YuzukiHD/R128Module/docs/hardware/ref_hardware_design.md

# 硬件设计参考

## R128 DevKit 开发板

- 硬件工程开源地址：[https://oshwhub.com/gloomyghost/r128-module](https://oshwhub.com/gloomyghost/r128-module)
- 电路图：[SCH_R128-DevKit_2023-09-05.pdf](https://www.aw-ol.com/downloads?cat=22)
- PCB：[ProDocument_R128-DevKit_2023-09-05.epro](https://www.aw-ol.com/downloads?cat=22)
- GERBER：[Gerber_R128-DevKit_2023-09-05.zip](https://www.aw-ol.com/downloads?cat=22)
- STL：[DXF_R128-DevKit_2023-09-05.dxf](https://www.aw-ol.com/downloads?cat=22)
- 3D STEP：[3D_R128-DevKit_2023-09-05.step](https://www.aw-ol.com/downloads?cat=22)
- BOM：[BOM_R128-DevKit_R128-DevKit_2023-09-05.xlsx](https://www.aw-ol.com/downloads?cat=22)
- 点位图：[PickAndPlace_R128-DevKit_2023-09-05.xlsx](https://www.aw-ol.com/downloads?cat=22)

## R128 EVT 开发套件

- 硬件工程开源地址：[https://oshwhub.com/gloomyghost/r128-module](https://oshwhub.com/gloomyghost/r128-module)
- 电路图：[SCH_R128_EVT_2023-10-20.pdf](https://www.aw-ol.com/downloads?cat=22)
- PCB：[ProDocument_R128-EVT_2023-10-20.epro](https://www.aw-ol.com/downloads?cat=22)
- GERBER：[Gerber_R128_EVT_2023-10-20.zip](https://www.aw-ol.com/downloads?cat=22)
- STL：[DXF_R128_EVT_2023-10-20.dxf](https://www.aw-ol.com/downloads?cat=22)
- 3D STEP：[3D_R128_EVT_2023-10-20.zip](https://www.aw-ol.com/downloads?cat=22)
- BOM：[BOM_R128-EVT_R128_EVT_2023-10-20.xlsx](https://www.aw-ol.com/downloads?cat=22)
- 点位图：[PickAndPlace_R128_EVT_2023-10-20.xlsx](https://www.aw-ol.com/downloads?cat=22)

## R128 模块

- 硬件工程开源地址：https://oshwhub.com/gloomyghost/r128-module
- 电路原理图：[SCH_R128-S2_2023-10-08.pdf](https://www.aw-ol.com/downloads?cat=22)
- PCB图：[PCB_R128-S2_2023-10-08.pdf](https://www.aw-ol.com/downloads?cat=22)
- PCB：[ProDocument_R128-S2-N16R16_2023-10-08.epro](https://www.aw-ol.com/downloads?cat=22)
- GERBER：[SCH_R128-S2_2023-10-08.pdf](https://www.aw-ol.com/downloads?cat=22)
- ODB++：[odb++_pcb_2023-10-08.zip](https://www.aw-ol.com/downloads?cat=22)
- 3D STEP：[3D_R128-S2_2023-10-08.zip](https://www.aw-ol.com/downloads?cat=22)
- BOM：[BOM_R128-S2-N16R16_R128-S2_2023-10-08.xlsx](https://www.aw-ol.com/downloads?cat=22)
- 点位图：[PickAndPlace_R128-S2_2023-10-08.xlsx](https://www.aw-ol.com/downloads?cat=22)
- 引脚图：[R128-S2-N16R16_PINOUT.svg](https://www.aw-ol.com/downloads?cat=22)
