YuzukiHD/R128Module/docs/hardware/chip_support_list.md

# 芯片外设支持列表

## LCD 显示屏
| 厂商 | 分辨率 | 型号 | 接口 | FPS  |
| --- | --- | --- | ---- | ---- |
| 100ask | 480 x 320 | Dshan_Display Module | SPI  | 60 |

## 摄像头 Sensor

| 厂商 | 分辨率 | 型号 | Size  | 接口 | FPS  |
| --- | --- | --- | ----- | ---- | ---- |
| GalaxyCore | VGA, 640 x 480 | GC0308 | 1/6.5 | DVP  | 30 |
| GalaxyCore | UXGA, 1616 x 1232 | GC2145 | 1/5 | DVP  | 13 |
