YuzukiHD/R128Module/docs/demo/lvgl_spi.md

# LVGL 与 SPI TFT GUI

本次使用的是 Dshan_Display Module，如下图：



引脚配置如下：

| R128 Devkit | TFT 模块 |
| --- | --- |
| PA12 | CS |
| PA13 | SCK |
| PA18 | MOSI |
| PA9 | PWM |
| PA20 | RESET |
| PA19 | RS |
| 3V3 | 3.3V |
| GND | GND |



## 载入方案

我们使用的开发板是 R128-Devkit，需要开发 C906 核心的应用程序，所以载入方案选择 `r128s2_module_c906`

```bash
$ source envsetup.sh 
$ lunch_rtos 1
```



## 配置 SPI LCD 驱动

驱动配置请参照 《SPI 驱动 TFT LCD 屏》文章进行配置。

## 配置 LVGL 软件包

运行 `mrtos_menuconfig` 进入配置页面。在如下地址找到勾选相关软件包。

```
System components  --->
	thirdparty components  --->
		[*] Littlevgl-8  --->
			[*]   lvgl examples
			[*]   lvgl-8.1.0 use sunxifb double buffer
			[*]   lvgl-8.1.0 use sunxifb cache
```

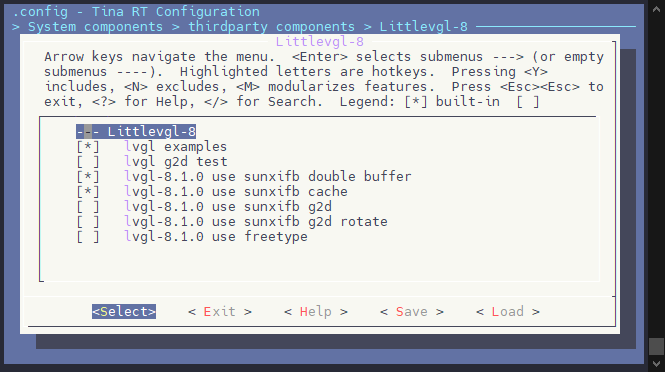
[picture p103: docs/demo/assets/post/lvgl_spi/image-20230825153504625.png]


注意，`lv_examples` 与 `lv_g2d_test` 不能同时勾选，否则会报错重复定义错误。

> 论坛提问：[想给R128移植上LVGL按照教程结果失败](https://bbs.aw-ol.com/topic/4421/share/1)



错误如下：

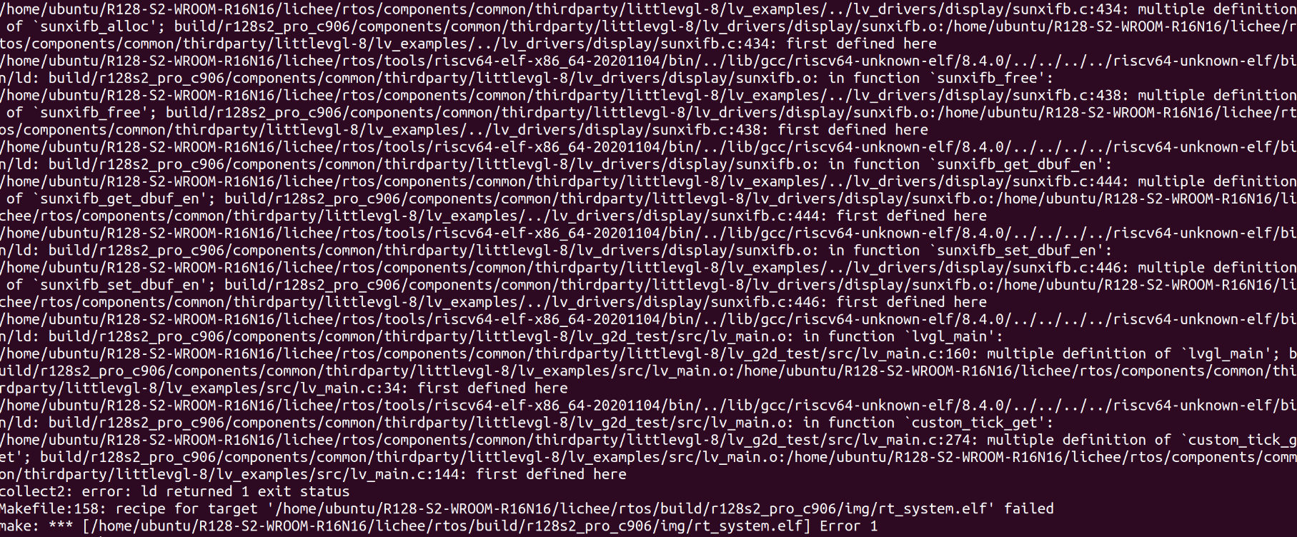
[picture p104: docs/demo/assets/post/lvgl_spi/image-20231016111544273.png]


如果出现 `update_mbr_failed`，请参照[常见问题](/others/faq)修改分区表增大分区容量

## 修改 LVGL 显示配置

### SPI 屏幕

进入 `lichee/rtos-components/thirdparty/littlevgl-8/lv_examples/src/lv_conf.h` 找到 `LV_COLOR_DEPTH` 并修改为 16 位，`LV_COLOR_16_SWAP` 置为 1 进行红蓝颜色交换。

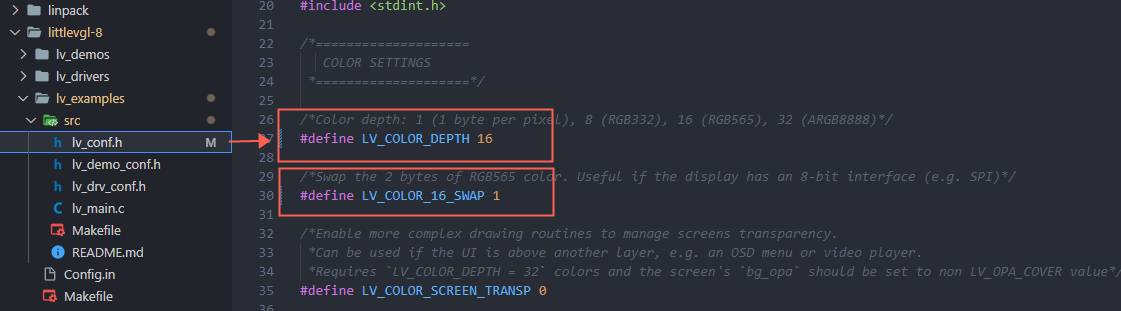
[picture p105: docs/demo/assets/post/lvgl_spi/image-20230825153629754.png]


### DBI 屏幕

进入 `lichee/rtos-components/thirdparty/littlevgl-8/lv_examples/src/lv_conf.h` 找到 `LV_COLOR_DEPTH` 并修改为 16 位，DBI 不需要配置`LV_COLOR_16_SWAP` 



## 测试

编译打包刷写后，在控制台输入 `lv_examples`  可以查看相关命令。

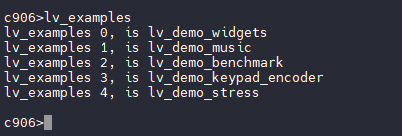
[picture p106: docs/demo/assets/post/lvgl_spi/image-20230825153901829.png]


运行 `lv_examples 1` 即可在屏幕显示 LVGL 界面。



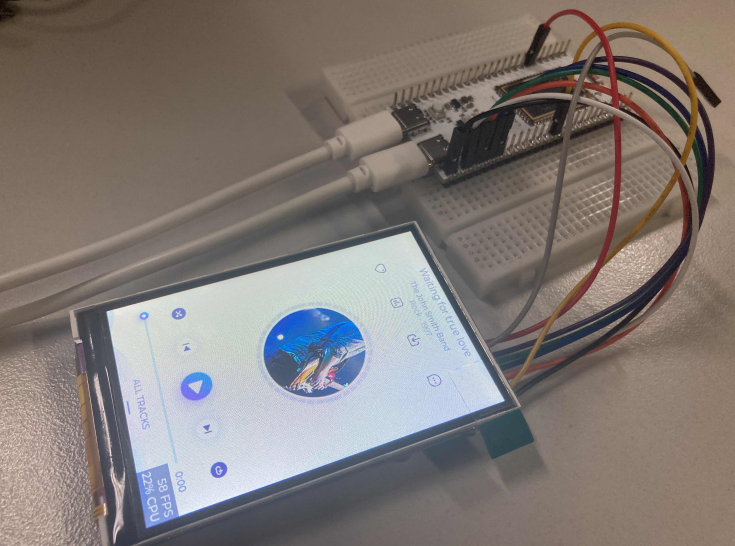
[picture p107: docs/demo/assets/post/lvgl_spi/image-20230825154036301.png]
