YuzukiHD/R128Module/docs/demo/spi_vs_dbi.md

# SPI 与 DBI 性能对比

R128 平台的 SPI 接口参数如下

 * 全双工同步串行接口
 * Master/Slave模式可配置
 * 支持最大96MHz时钟频率
 * 支持SPI Mode0/1/2/3
 * 片选和时钟的极性和相位可配置
 * 5个时钟源
 * 支持中断或DMA传输
 * 支持多片选
 * 支持Standard Single/Dual/Quad SPI，FIFO深度64B
 * 支持BIT模式，用于3Wire场景，支持可编程0~32bits帧长度（仅支持Master模式，且不支持DMA和FIFO功能）
 * 支持DBI模式，用于显示设备场景，用于传输视频数据

R128 平台的 DBI 接口参数如下

- 支持DBI Type C 3线/4线接口模式
- 支持2数据通道接口模式
- 支持从CPU或DMA获取数据源
- 支持RGB111/444/565/666/888视频格式
- 在单数据通道下，最大分辨率为RGB666 240 x 320 @ 30Hz
- 在双数据通道下，最大分辨率为RGB888 240 x 320 @ 60Hz或320 x 480 @ 30Hz
- 支持TE
- 支持软件灵活控制视频帧率

## 测试结果

| 屏幕 | SPI 模式 lv_music_demo | SPI 模式 lv_benchmark | DBI 模式 lv_music_demo | DBI 模式 lv_benchmark |
| --- | --- | --- | --- | --- |
| 1.3 寸 240x240  | 33 | 49 | 38 | 60 |
| 2.4 寸 320x240  | 22 | 30 | 26 | 36 |
| 1.47 寸 172x320 | 33 | 50 | 38 | 67 |

## 测试数据

### ST7789v 1.3 寸 240x240 屏幕测试

#### DBI 模式

- lv_music_demo 跑分：38fps

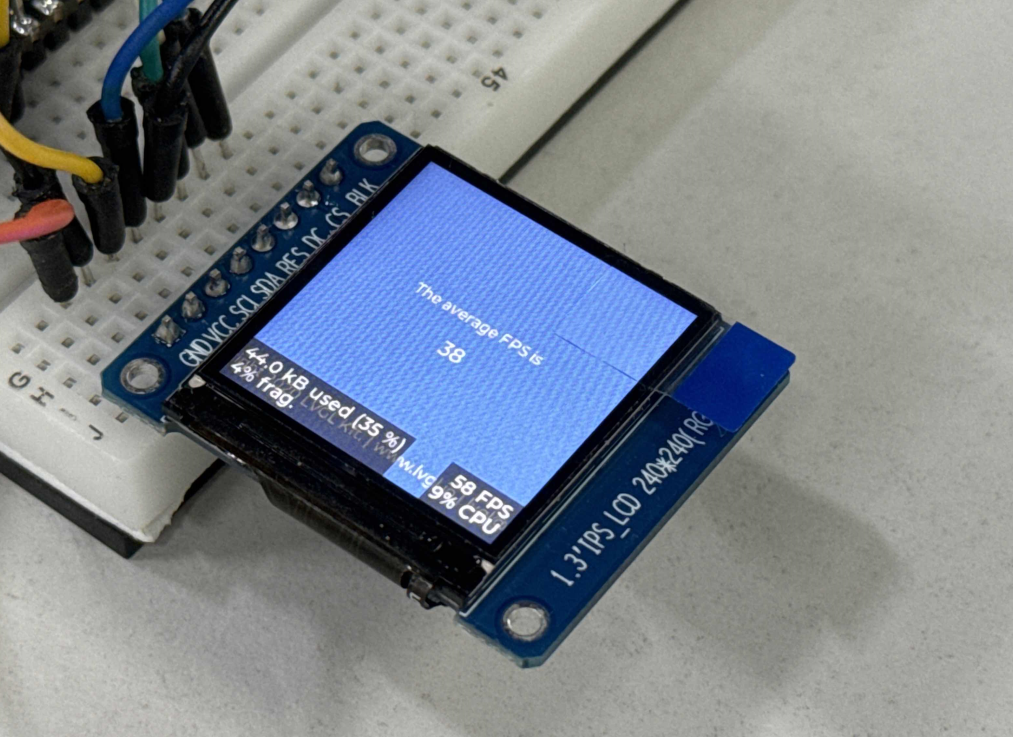
[picture p108: docs/demo/assets/post/spi_vs_dbi/image-20231031151025338.png]


- lv_benchmark 跑分：60fps

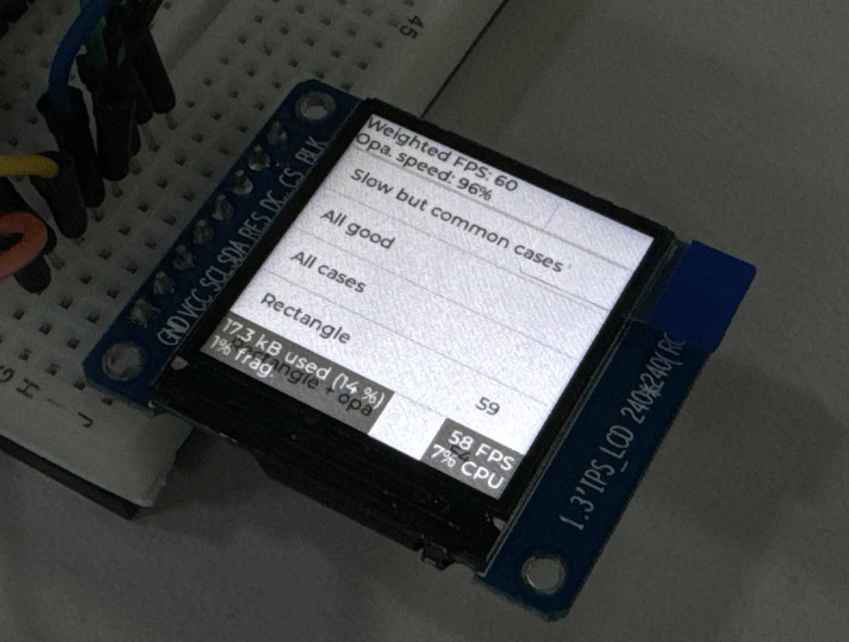
[picture p109: docs/demo/assets/post/spi_vs_dbi/image-20231031151100739.png]


#### SPI 模式

- lv_music_demo 跑分：33fps

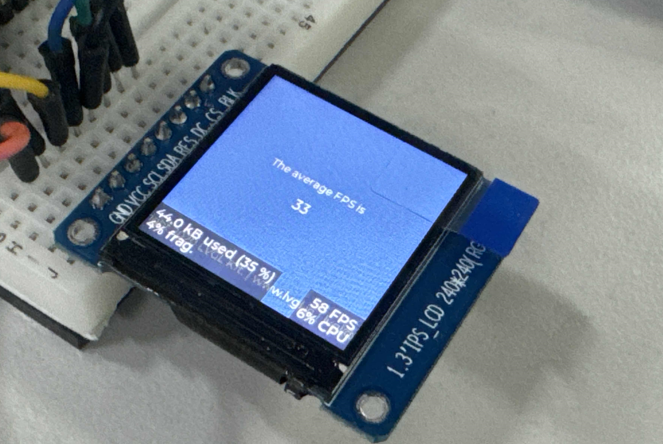
[picture p110: docs/demo/assets/post/spi_vs_dbi/image-20231031151746912.png]


- lv_benchmark 跑分：49fps

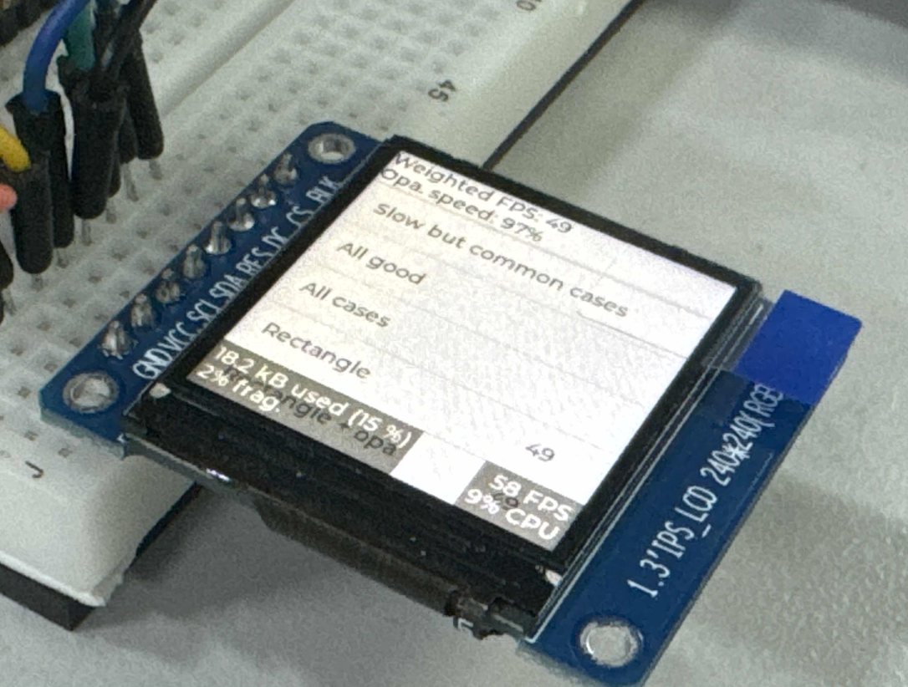
[picture p111: docs/demo/assets/post/spi_vs_dbi/image-20231031152154886.png]


### ST7789v 2.4 寸 320x240 屏幕测试

#### DBI 模式

- lv_music_demo 跑分：26fps

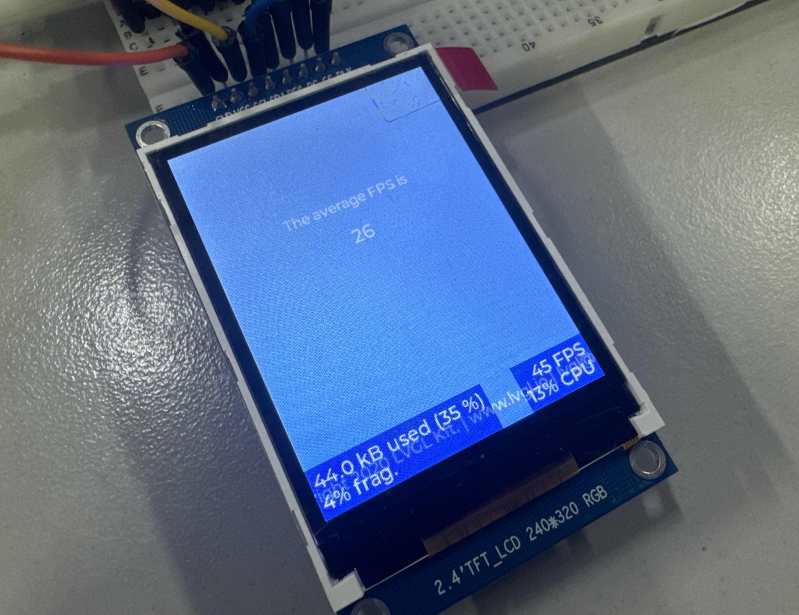
[picture p112: docs/demo/assets/post/spi_vs_dbi/image-20231031153826567.png]


- lv_benchmark 跑分：36fps

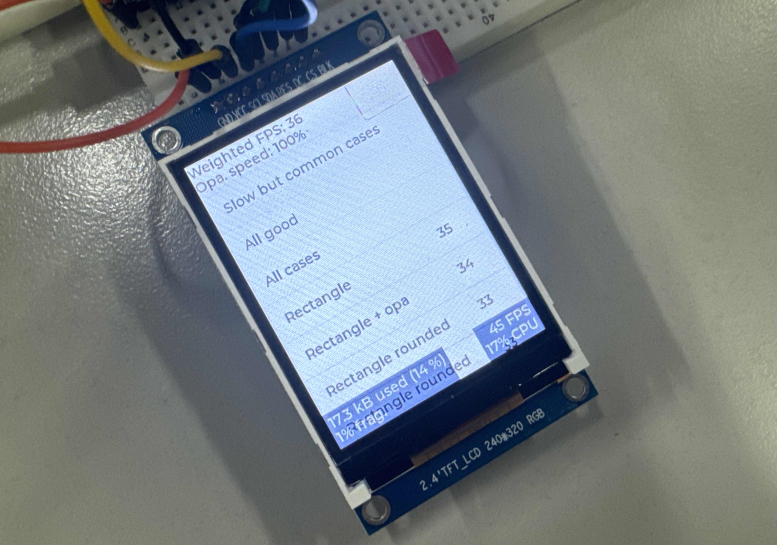
[picture p113: docs/demo/assets/post/spi_vs_dbi/image-20231031154015529.png]


#### SPI 模式

- lv_music_demo 跑分：22fps

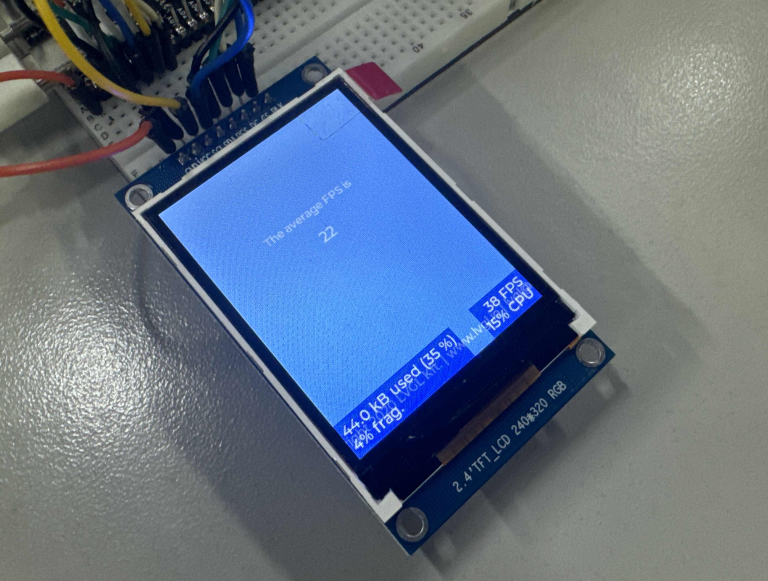
[picture p114: docs/demo/assets/post/spi_vs_dbi/image-20231031153251552.png]


- lv_benchmark 跑分：30fps

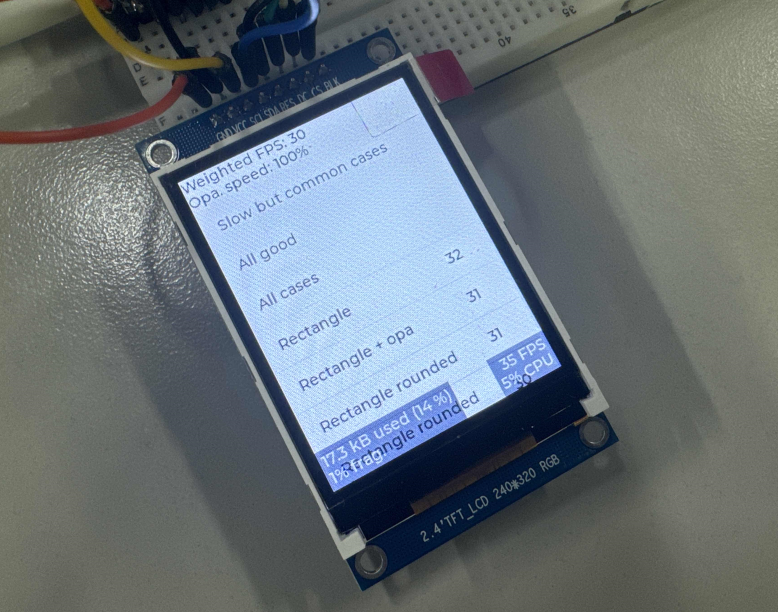
[picture p115: docs/demo/assets/post/spi_vs_dbi/image-20231031153459031.png]


### ST7789v 1.47 寸 172x320 屏幕测试

#### DBI 模式

- lv_music_demo 跑分：38fps

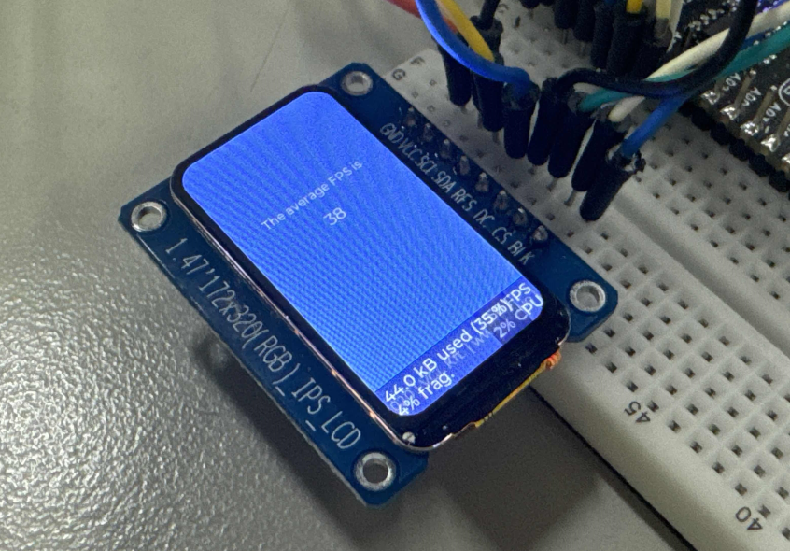
[picture p116: docs/demo/assets/post/spi_vs_dbi/image-20231031154447696.png]


- lv_benchmark 跑分：67fps

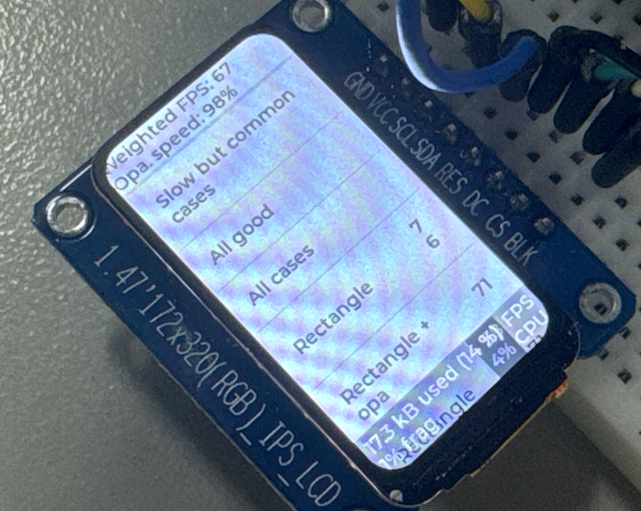
[picture p117: docs/demo/assets/post/spi_vs_dbi/image-20231031154914899.png]


#### SPI 模式

- lv_music_demo 跑分：33fps

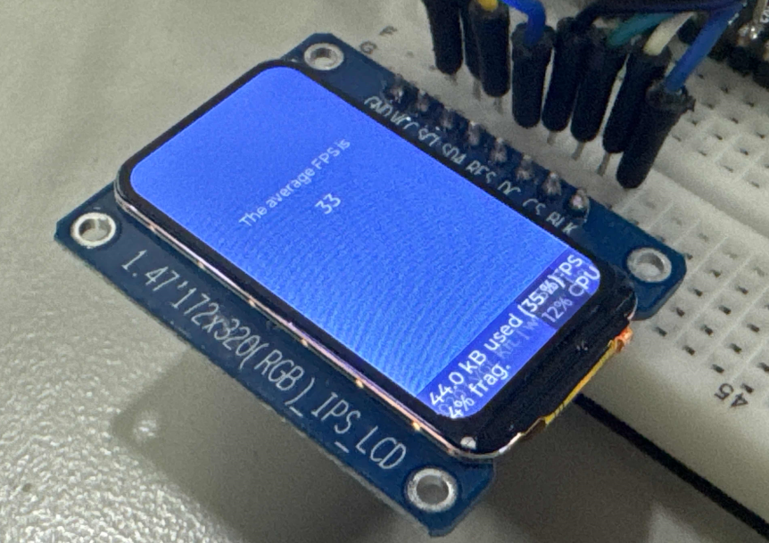
[picture p118: docs/demo/assets/post/spi_vs_dbi/image-20231031155353234.png]


- lv_benchmark 跑分：50fps

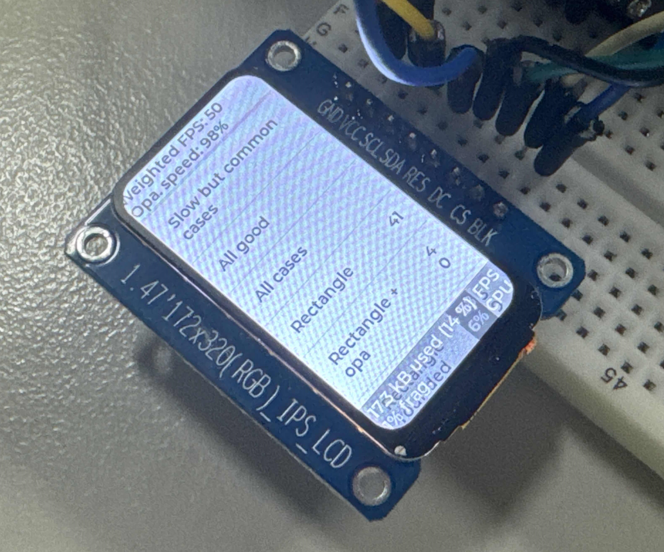
[picture p119: docs/demo/assets/post/spi_vs_dbi/image-20231031155606350.png]


### RGB ST7701s 4寸 480x480 屏幕基准

- lv_benchmark 跑分：247fps

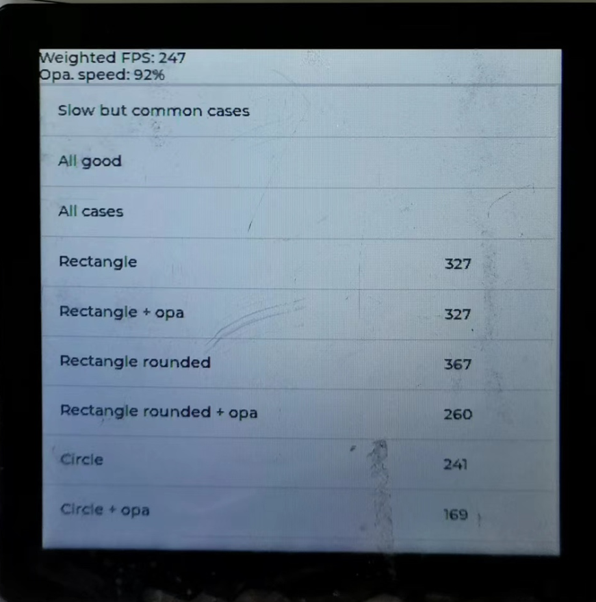
[picture p120: docs/demo/assets/post/spi_vs_dbi/image-20231031153630230.png]
