YuzukiHD/R128Module/docs/r128/get_chip_ds.md

# 手册与资料

## CPU手册

- Arm M33 Star 核心手册： [Arm® M33 Star Processor Technical Reference Manual](https://developer.arm.com/documentation/100230/latest/)
- XuanTie C906 核心手册：[T-Head XuanTie C906 Processor Datasheet](https://xuantie.t-head.cn/product/xuantie/3817197695983423488)

## DSP 相关

- HIFI 5 DSP 相关：[HiFi 5 DSP](https://www.cadence.com/en_US/home/tools/ip/tensilica-ip/hifi-dsps/hifi-5.html)
- Xtensa Xplorer 下载地址：[Xplorer Software (SDK) Download](https://www.cadence.com/en_US/home/tools/ip/tensilica-ip/sdk-download.html)
- Xtensa Xplorer 授权申请： [Cadence Tensilica Offerings](https://www.cadence.com/en_US/home/tools/ip/tensilica-ip/technologies.html)
- Xtensa Xplorer 试用申请：[request an evaluation license](https://www.cadence.com/en_US/home/tools/ip/tensilica-ip/tensilica-sdk-evaluation-request-form.html)

> 其余手册将在发布后上传
