YuzukiHD/R128Module/docs/sdk_base/gpio_mux.md

# 配置引脚复用

## 本文中的约定

- 描述 GPIO 配置的形式：`Port:端口 + 组内序号<功能分配><内部电阻状态><驱动能力><输出电平状态>`
- 文中的 `<X>=0,1,2,3,4,5…..`，如 twi0，twi1….；uart0，uart1….。
- 文中的 `{PROJECT}` 代表不同的方案，例如 `module` 方案。

## 引脚配置文件配置复用

R128 平台使用 `sys_config.fex` 作为引脚配置文件，他会在打包时打包编译进入系统，在系统运行时会解析并配置，系统解析 `sys_config.fex` 的驱动配置位于 `lichee\rtos-components\aw\sys_config_script` 中。

对于配置引脚复用，只需要修改  `board\r128s2\{PROJECT}\config\sys_config.fex`  文件即可。

### GPIO描述格式

```
Port:端口 + 组内序号<功能分配><内部电阻状态><驱动能力><输出电平状态>
```

示例

```ini
uart_tx = port:PA16<5><1><2><0>
                |----------------------> 端口号 PA
                  |--------------------> 序号 19
                    |------------------> 功能分配 5 （参考 PINMUX）
                       |---------------> 内部电阻状态为 1  
                          |------------> 驱动能力为 2
                             |---------> 默认输出电平 0
```

### [product]

配置文件信息

| 配置项  | 配置项含义 |
| --- | --- |
| version | 配置的版本号 |
| machine | 方案名字 |

示例

```ini
[product]
version = "100"
machine = "module"
```

### [target]

启动介质配置

| 配置项 | 配置项含义 |
| --- | --- |
| storage_type | 启动介质选择 <br />0:nand <br />1:sd<br />2:emmc<br />3:spinor <br />4:emmc <br />5:spinand <br />6:sd <br />-1:(defualt) 自动扫描启动介质 |

示例

```ini
[target]
storage_type    = 3
```

> 对于内置 SPI NOR 的 R128 平台，请配置为 `3`

### [platform]

配置 boot0 调试信息打印

| 配置项 | 配置项含义 |
| --- | --- |
| debug_mode | 配置0时，boot0 不打印调试信息，配置不为0时打印 |

示例

```ini
[platform]
debug_mode = 2
```

### [uart_para]

boot0 调试串口配置

| 配置项 | 配置项含义 |
| --- | --- |
| uart_debug_port | boot0 调试输出串口使用的串口号 |
| uart_debug_tx | boot0 调试串口 tx 使用的引脚 |
| uart_debug_rx | boot0 调试串口 rx 使用的引脚 |

示例

```ini
[uart_para]
uart_debug_port = 0
uart_debug_tx   = port:PA16<5><1><default><default>
uart_debug_rx   = port:PA17<5><1><default><default>
```

### [uartX]

UART 引脚配置

| 配置项 | 配置项含义 |
| --- | --- |
| uart_tx | UART TX 的 GPIO 配置 |
| uart_rx | UART RX 的 GPIO 配置 |
| uart_type | UART 类型，有效值为：2/4/8; 表示 2/4/8 线模式 |

示例

```ini
[uart0]
uart_tx         = port:PA16<5><1><default><default>
uart_rx         = port:PA17<5><1><default><default>
```

### [twiX]

TWI 引脚配置

| 配置项 | 配置项含义 |
| --- | --- |
| twiX_sck | TWI 的时钟的 GPIO 配置 |
| twiX_sda | TWI 的数据的 GPIO 配置 |

### [sdcX]

SDIO，MMC 引脚配置

| 配置项 | 配置项含义 |
| --- | --- |
| card_ctrl | 控制器 |
| card_high_speed | 速度模式 0 为低速，1 为高速 |
| card_line | 1，4 线卡可以选择 |
| sdc_d1 | sdc 卡数据 1 线信号的 GPIO 配置 |
| sdc_d0 | sdc 卡数据 2 线信号的 GPIO 配置 |
| sdc_clk | sdc 卡时钟信号的 GPIO 配置 |
| sdc_cmd | sdc 命令信号的 GPIO 配置 |
| sdc_d3 | sdc 卡数据 3 线信号的 GPIO 配置 |
| sdc_d2 | sdc 卡数据 4 线信号的 GPIO 配置 |

示例

```ini
[sdc0]
card_ctrl       = 0
card_high_speed = 0
card_line       = 4
sdc_d1          = port:PA27<2><1><3><default>
sdc_d0          = port:PA26<2><1><3><default>
sdc_clk         = port:PA29<2><1><3><default>
sdc_cmd         = port:PA25<2><1><3><default>
sdc_d3          = port:PA24<2><1><3><default>
sdc_d2          = port:PA28<2><1><3><default>
```

### [sdcXdet_para]

卡检测引脚配置

| 配置项 | 配置项含义 |
| --- | --- |
| sdcX_det | 卡插入检测脚 |

示例

```ini
[sdc0det_para]
sdc0_det        = port:PA23<0><1><3><default>
```
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
