YuzukiHD/R128Module/docs/sdk_module/uart.md

# UART

Universal Asynchronous Receiver/Transmitter，通用异步收发传输器

- Compatible with industry-standard 16450/16550 UARTs
- 64-Byte Transmit and receive data FIFOs
- Supports DMA controller interface
- Supports Software/ Hardware Flow Control
- Supports IrDA 1.0 SIR
- Supports RS-485 mode

## 模块配置

其menuconfig 的配置如下：

```shell
Kernel Setup --->
    Drivers Setup --->
        SoC HAL Drivers --->
            UART devices --->
                [*] enable uart driver
                [*] enbale uart hal APIs Test command
```
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
