YuzukiHD/R128Module/docs/assets/post/README/image-20230319113235278-1691039559823-1.png

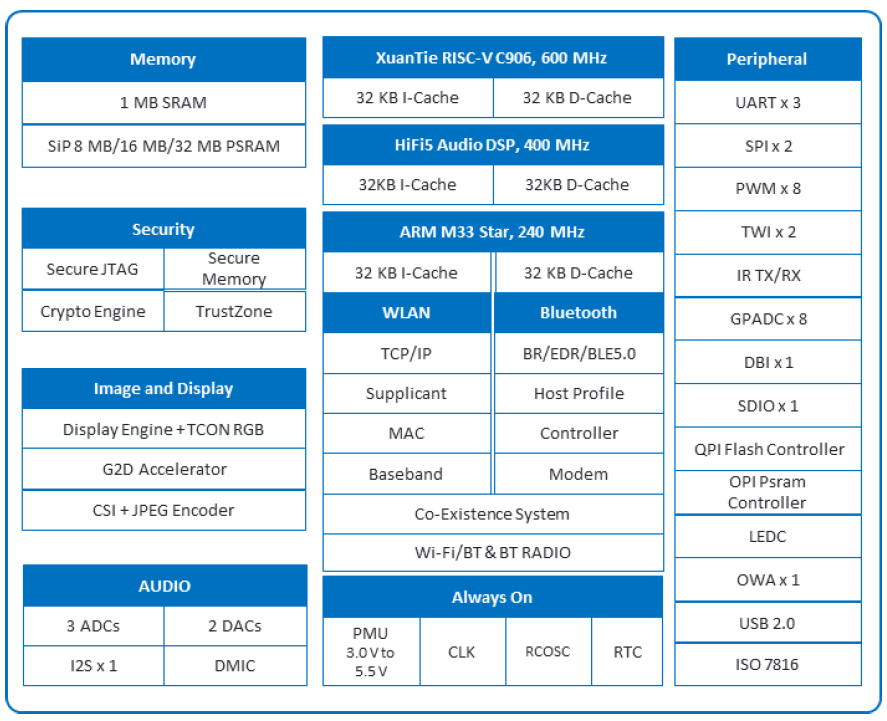
docs/assets/post/README/image-20230319113235278-1691039559823-1.png
