YuzukiHD/R128Module/docs/demo/assets/post/add_dbilcd_13/D2LI-16932054745466.png

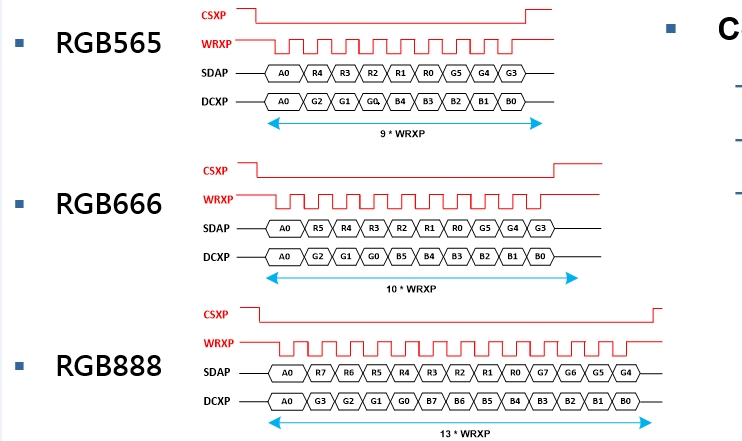
docs/demo/assets/post/add_dbilcd_13/D2LI-16932054745466.png
