YuzukiHD/R128Module/docs/demo/assets/post/add_dbilcd_13/image-20231016100913213.png

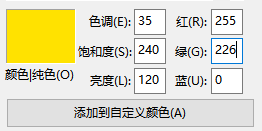
docs/demo/assets/post/add_dbilcd_13/image-20231016100913213.png
