YuzukiHD/R128Module/docs/demo/assets/post/add_dbilcd_13/image-20231016101233907.png

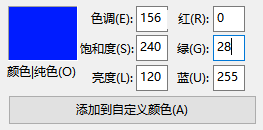
docs/demo/assets/post/add_dbilcd_13/image-20231016101233907.png
