YuzukiHD/R128Module/docs/demo/assets/post/add_dbilcd_13/image-20231031144435046.png

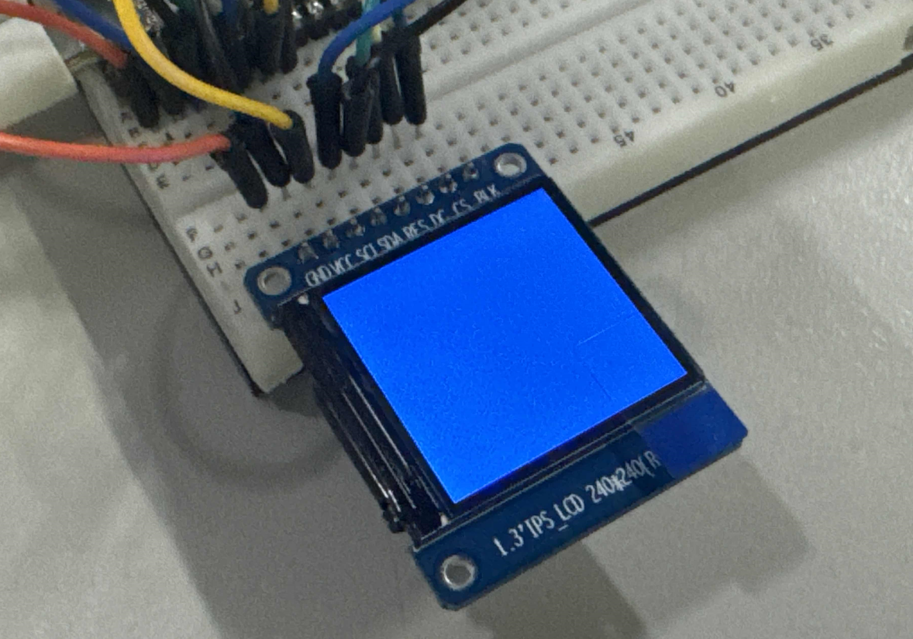
docs/demo/assets/post/add_dbilcd_13/image-20231031144435046.png
