YuzukiHD/R128Module/docs/demo/assets/post/add_dbilcd_13/L3I1-16932054745453.png

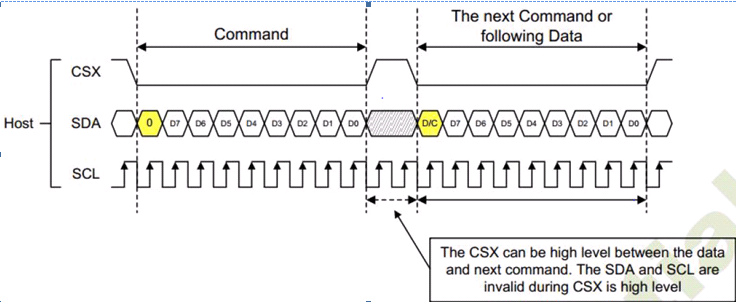
docs/demo/assets/post/add_dbilcd_13/L3I1-16932054745453.png
