YuzukiHD/R128Module/docs/demo/assets/post/add_dbilcd_13/L3I_RD-16932054745464.png

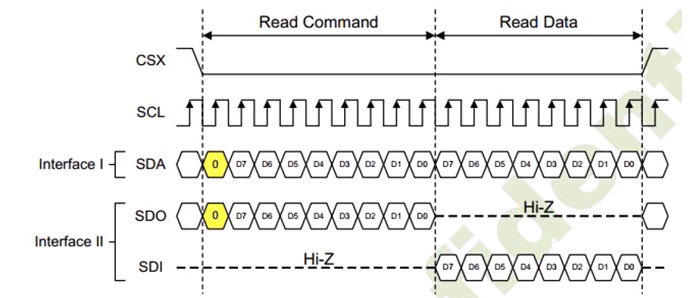
docs/demo/assets/post/add_dbilcd_13/L3I_RD-16932054745464.png
