YuzukiHD/R128Module/docs/demo/assets/post/add_spilcd_147/image-20231023102049260.png

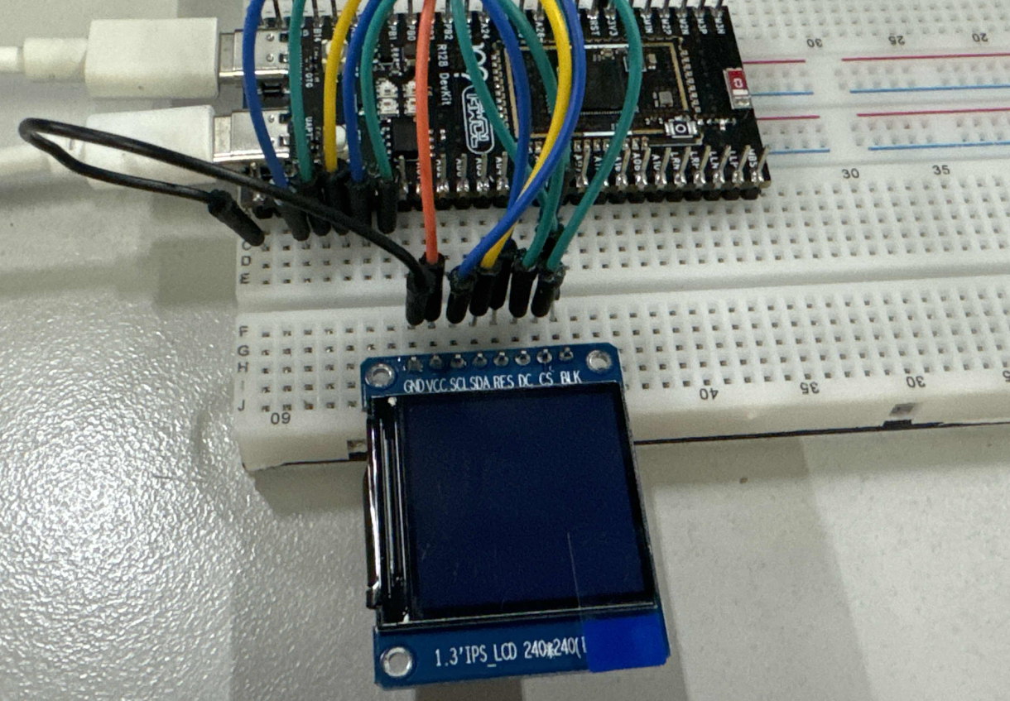
docs/demo/assets/post/add_spilcd_147/image-20231023102049260.png
