YuzukiHD/R128Module/docs/demo/assets/post/ncnn/image-20230904142021458.png

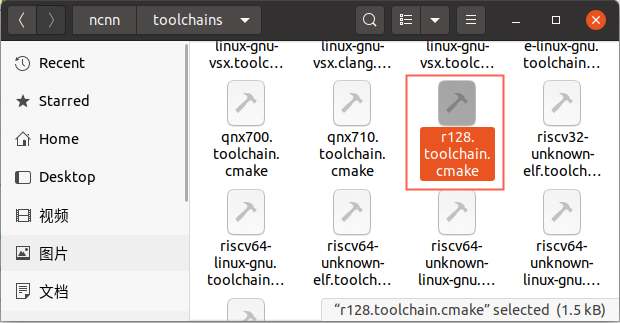
docs/demo/assets/post/ncnn/image-20230904142021458.png
