YuzukiHD/R128Module/docs/demo/assets/post/oled/image-20230824100826958.png

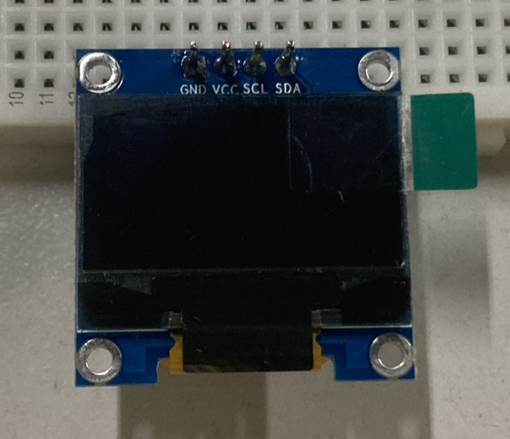
docs/demo/assets/post/oled/image-20230824100826958.png
