YuzukiHD/R128Module/docs/demo/assets/post/oled/image-20230824103012542.png

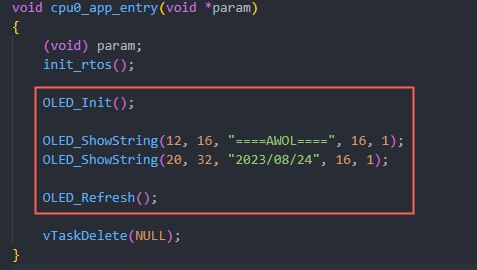
docs/demo/assets/post/oled/image-20230824103012542.png
