YuzukiHD/R128Module/docs/demo/assets/post/oled/image-20230824103128313.png

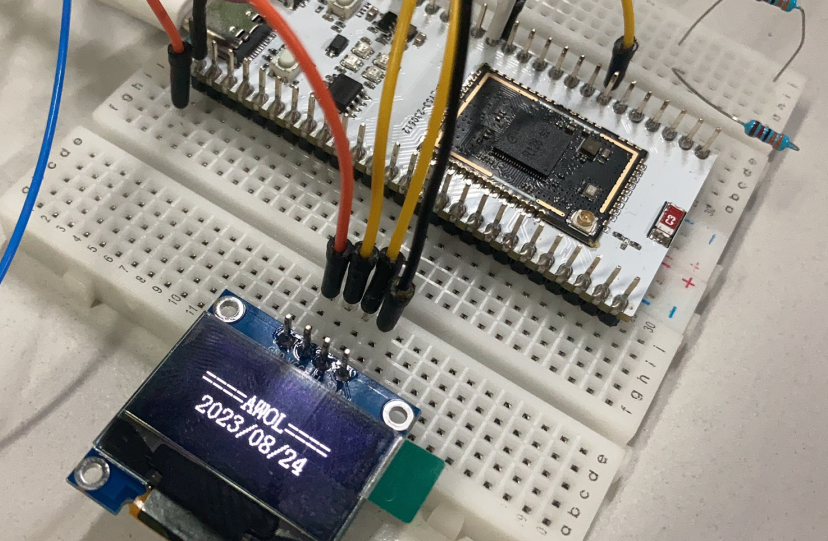
docs/demo/assets/post/oled/image-20230824103128313.png
