YuzukiHD/R128Module/docs/devkit/assets/post/r128_devkit/R128开发板资源1.png

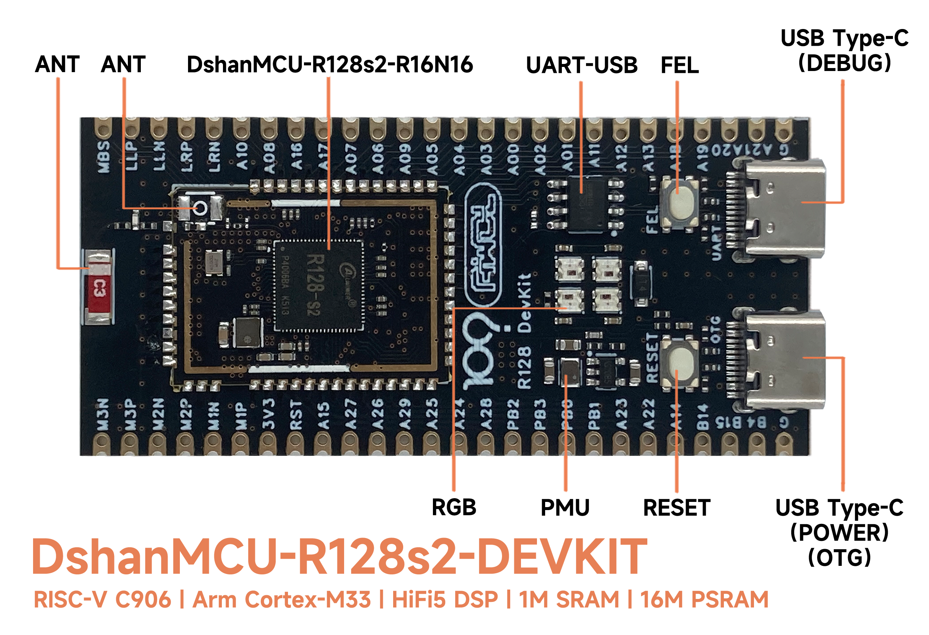
docs/devkit/assets/post/r128_devkit/R128开发板资源1.png
