YuzukiHD/R128Module/docs/devkit/assets/post/r128_evt/image-20231020133454019.png

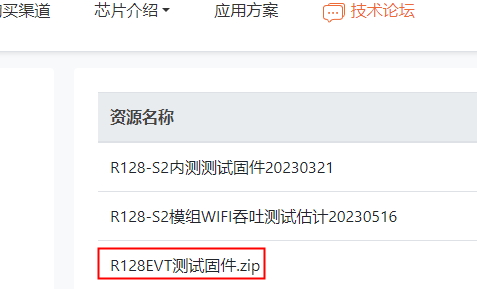
docs/devkit/assets/post/r128_evt/image-20231020133454019.png
