YuzukiHD/R128Module/docs/devkit/assets/post/r128_module/R128-S2.jpg

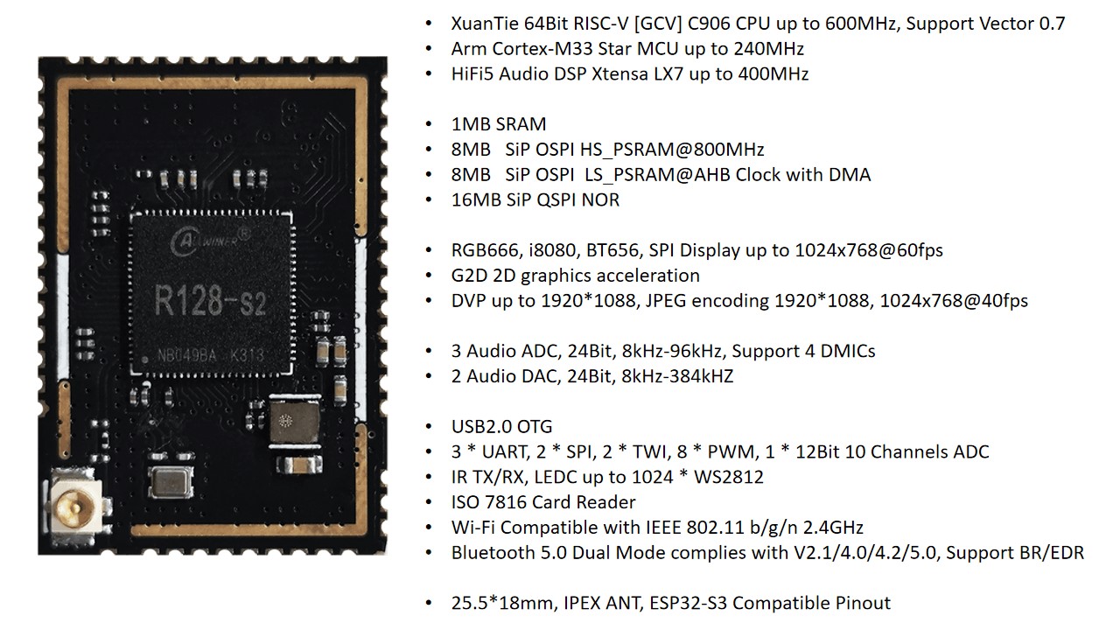
docs/devkit/assets/post/r128_module/R128-S2.jpg
