YuzukiHD/R128Module/docs/dsp/assets/post/dsp_intro/tensilica-hifi-idma-256.jpg

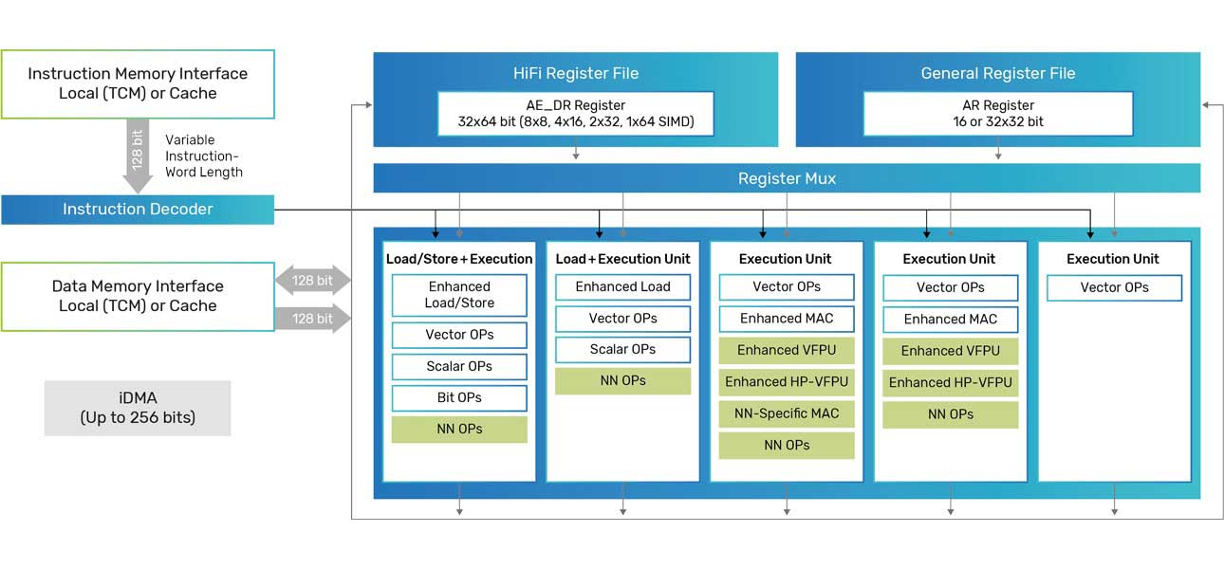
docs/dsp/assets/post/dsp_intro/tensilica-hifi-idma-256.jpg
