YuzukiHD/R128Module/docs/dsp/assets/post/dsp_sdk/image-20230729231813252.png

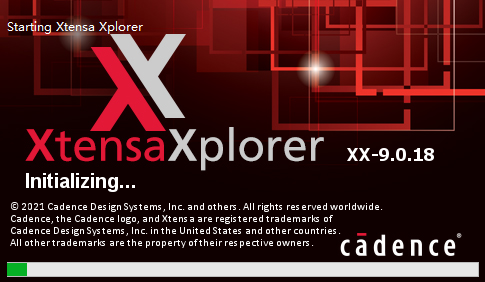
docs/dsp/assets/post/dsp_sdk/image-20230729231813252.png
