YuzukiHD/R128Module/docs/dsp/assets/post/dsp_sdk/image-20230729232029991.png

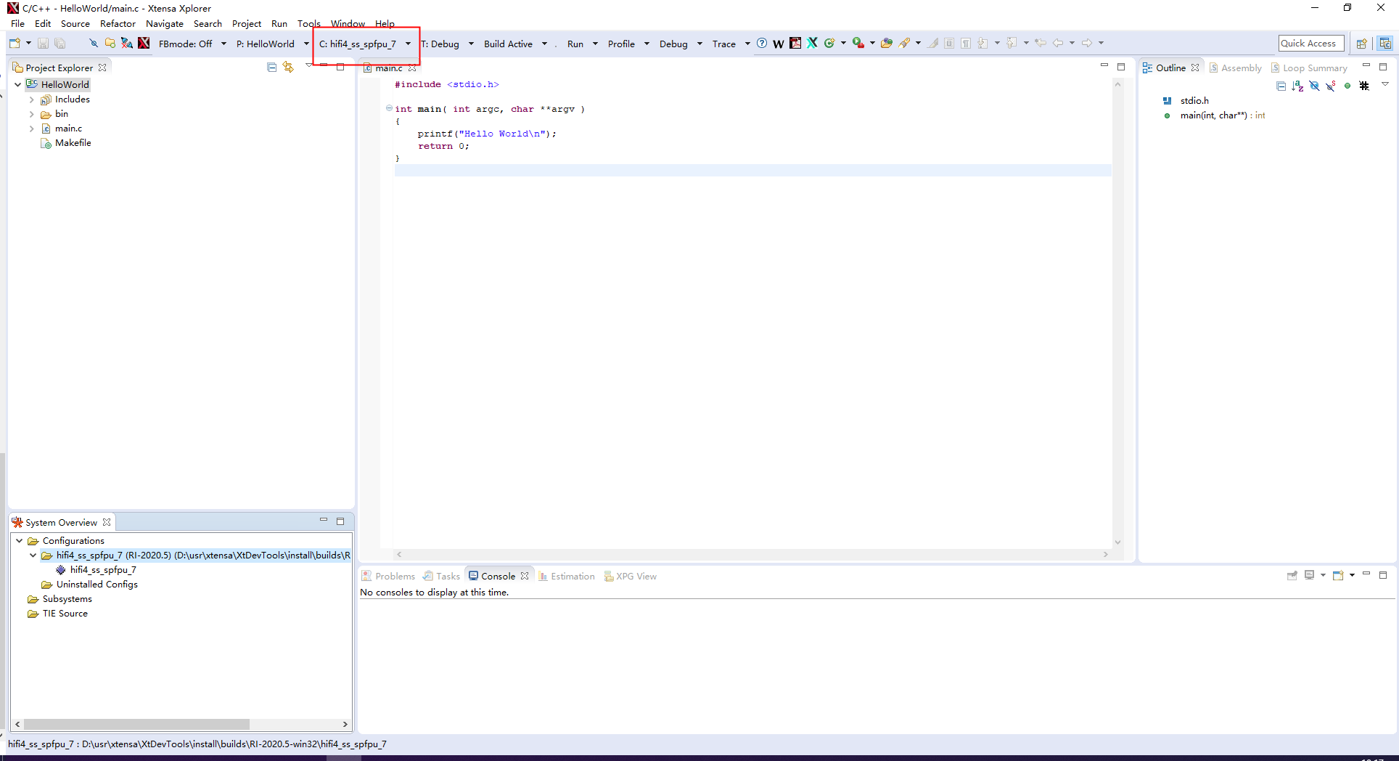
docs/dsp/assets/post/dsp_sdk/image-20230729232029991.png
