YuzukiHD/R128Module/docs/dsp/assets/post/dsp_sdk/image-20230729232040566.png

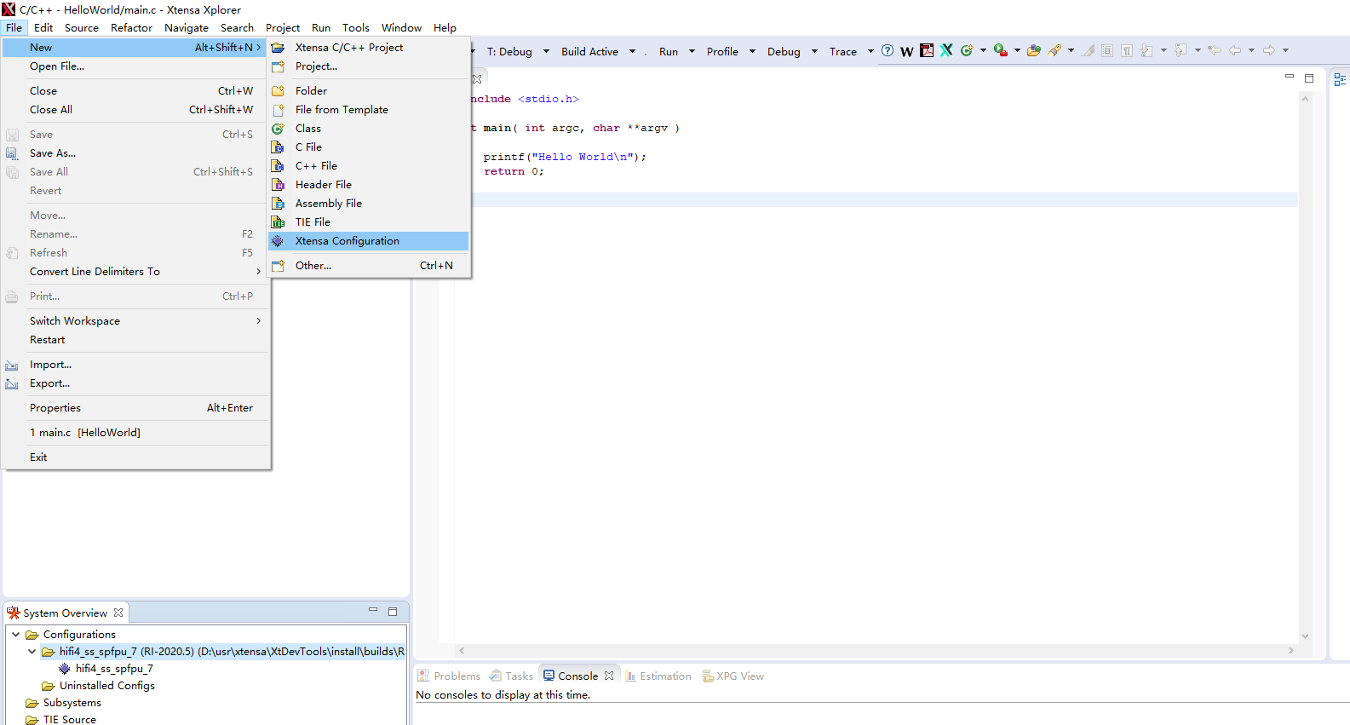
docs/dsp/assets/post/dsp_sdk/image-20230729232040566.png
