YuzukiHD/R128Module/docs/hardware/assets/post/hardware_design/image-20230319104813504.png

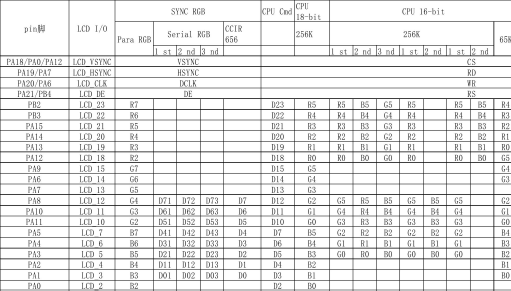
docs/hardware/assets/post/hardware_design/image-20230319104813504.png
