YuzukiHD/R128Module/docs/r128/assets/post/flash_img/image-20230329164517457.png

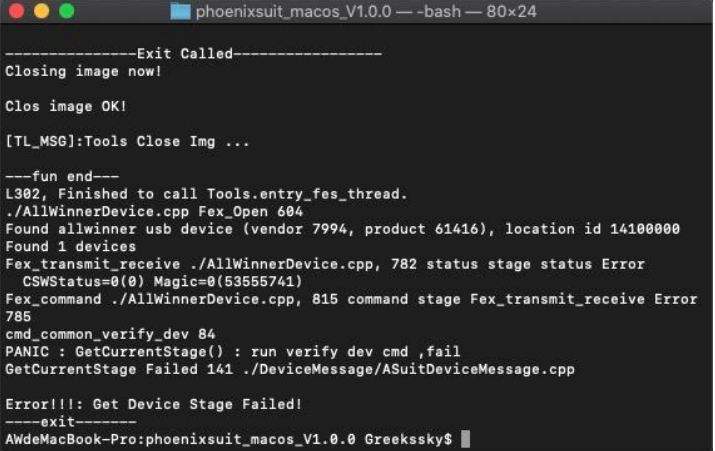
docs/r128/assets/post/flash_img/image-20230329164517457.png
