YuzukiHD/R128Module/docs/r128/assets/post/flash_img/image-20230823142647176.png

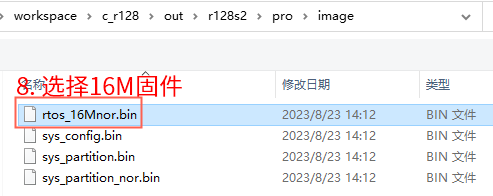
docs/r128/assets/post/flash_img/image-20230823142647176.png
