YuzukiHD/R128Module/docs/r128/assets/post/flash_img/image-20230823152129702.png

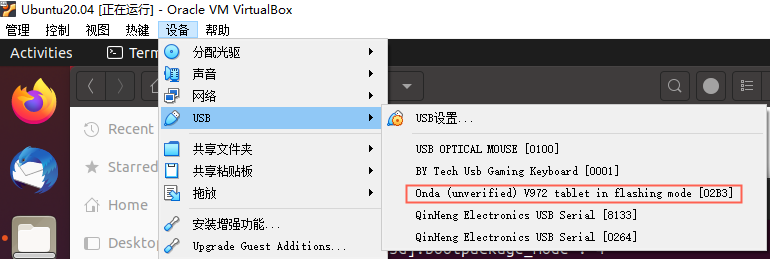
docs/r128/assets/post/flash_img/image-20230823152129702.png
