YuzukiHD/R128Module/docs/r128/assets/post/get_sdk/image-20230406110908680.png

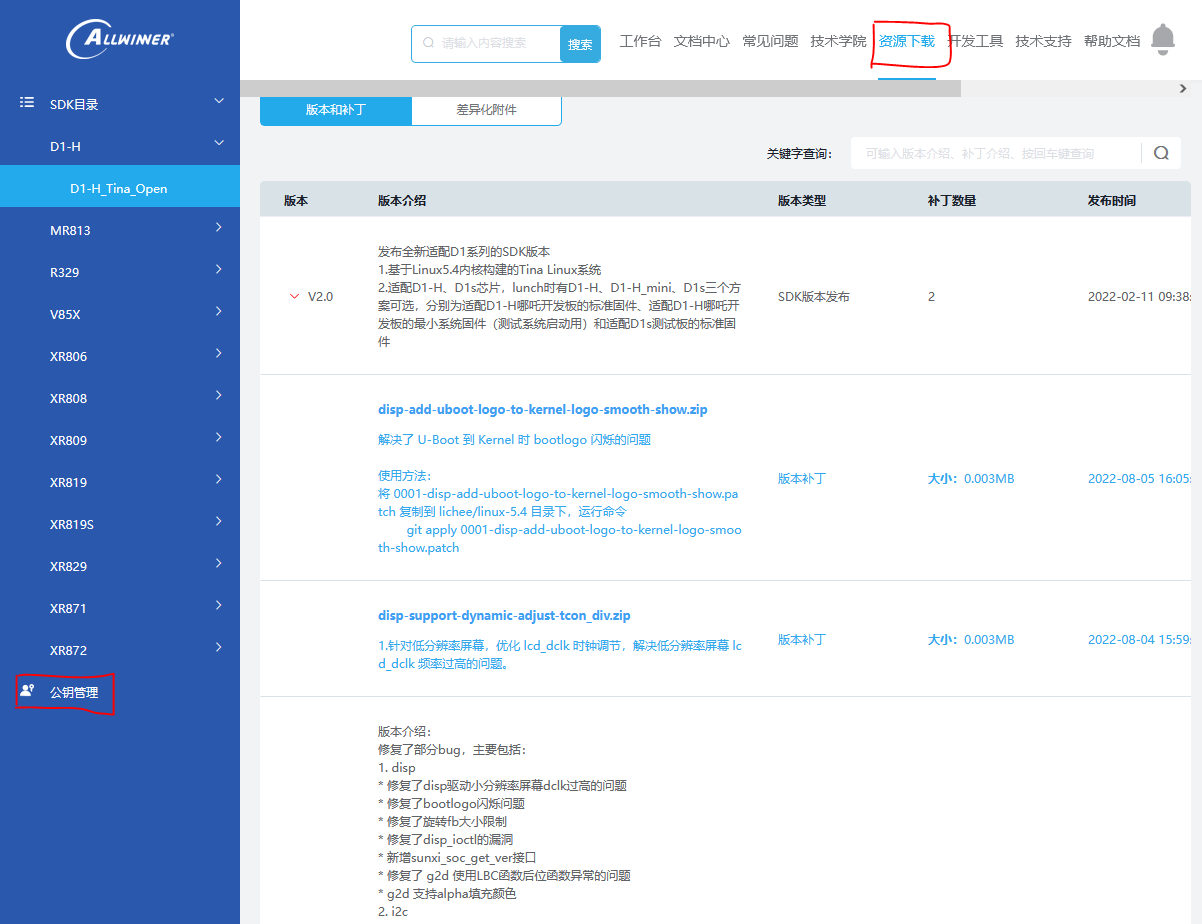
docs/r128/assets/post/get_sdk/image-20230406110908680.png
