YuzukiHD/R128Module/docs/r128/assets/post/get_sdk/image-20230406112405593.png

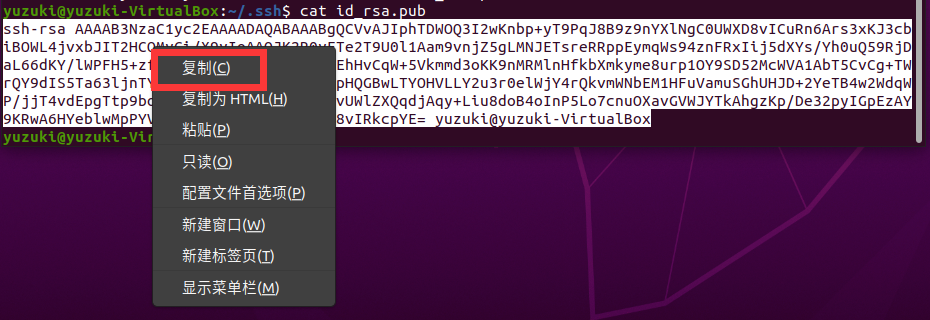
docs/r128/assets/post/get_sdk/image-20230406112405593.png
