YuzukiHD/R128Module/docs/r128/assets/post/get_sdk/image-20230728110029144.png

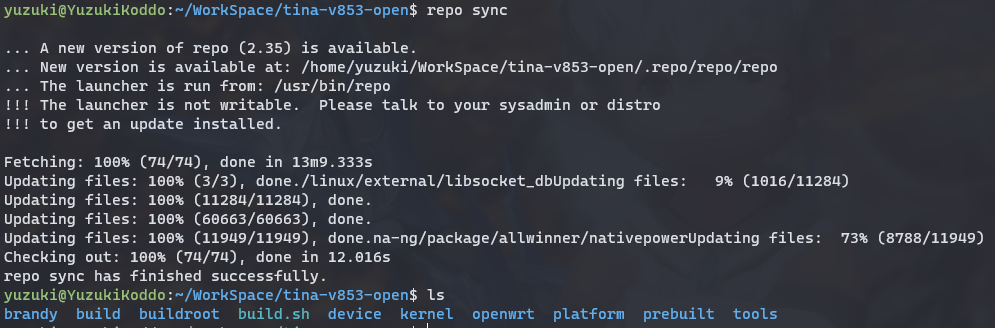
docs/r128/assets/post/get_sdk/image-20230728110029144.png
