YuzukiHD/R128Module/docs/r128/assets/post/hello_world/image-20230802110857786.png

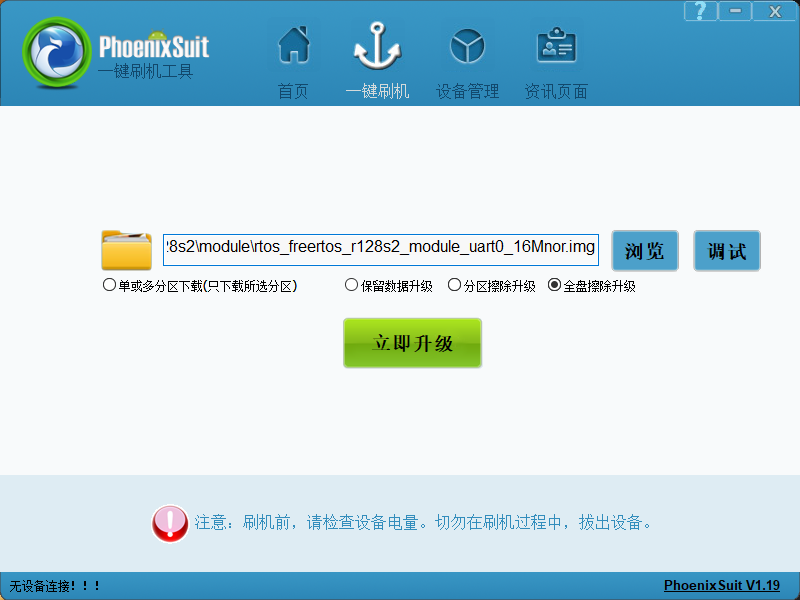
docs/r128/assets/post/hello_world/image-20230802110857786.png
