YuzukiHD/R128Module/docs/r128/assets/post/hello_world/image-20230802111147586.png

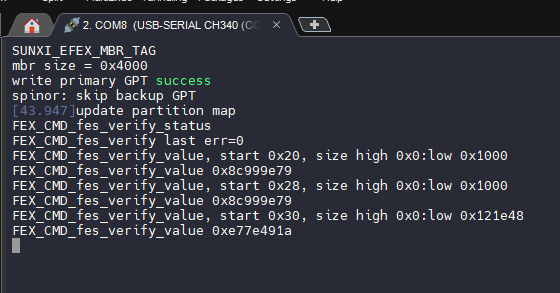
docs/r128/assets/post/hello_world/image-20230802111147586.png
