YuzukiHD/R128Module/docs/r128/assets/post/prepare_dev_env/1648732680712-8011100e-3e20-46a0-a4eb-c2bb372d6e6f-image.png

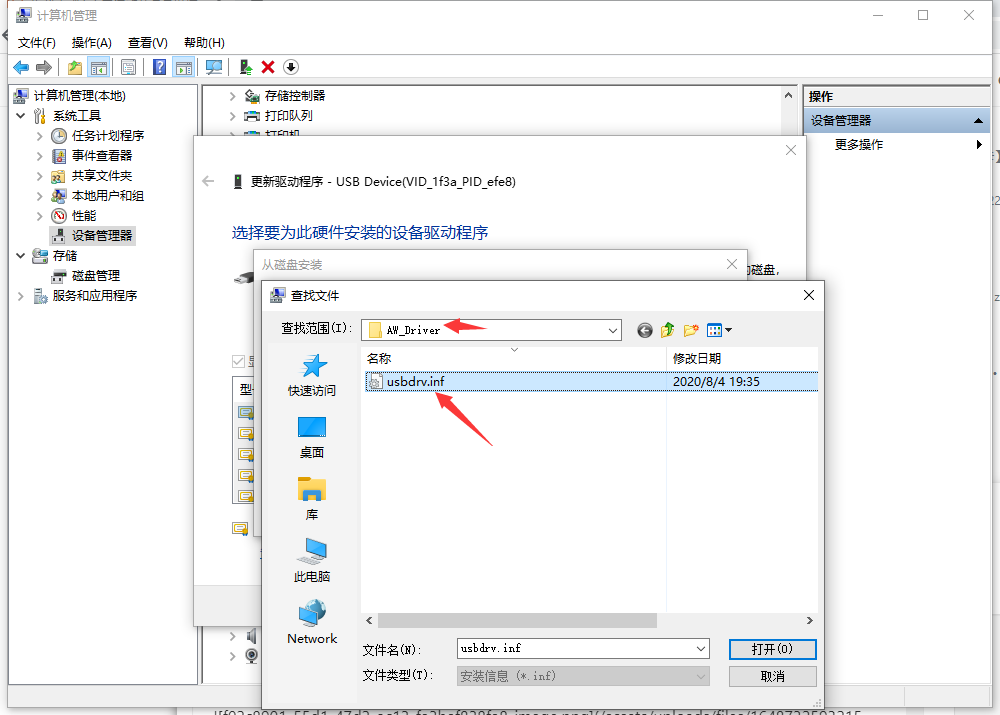
docs/r128/assets/post/prepare_dev_env/1648732680712-8011100e-3e20-46a0-a4eb-c2bb372d6e6f-image.png
