YuzukiHD/R128Module/docs/r128/assets/post/prepare_dev_env/1648732760111-c58ccd65-afd3-4bc9-b5f9-fd89f6b3ed66-image.png

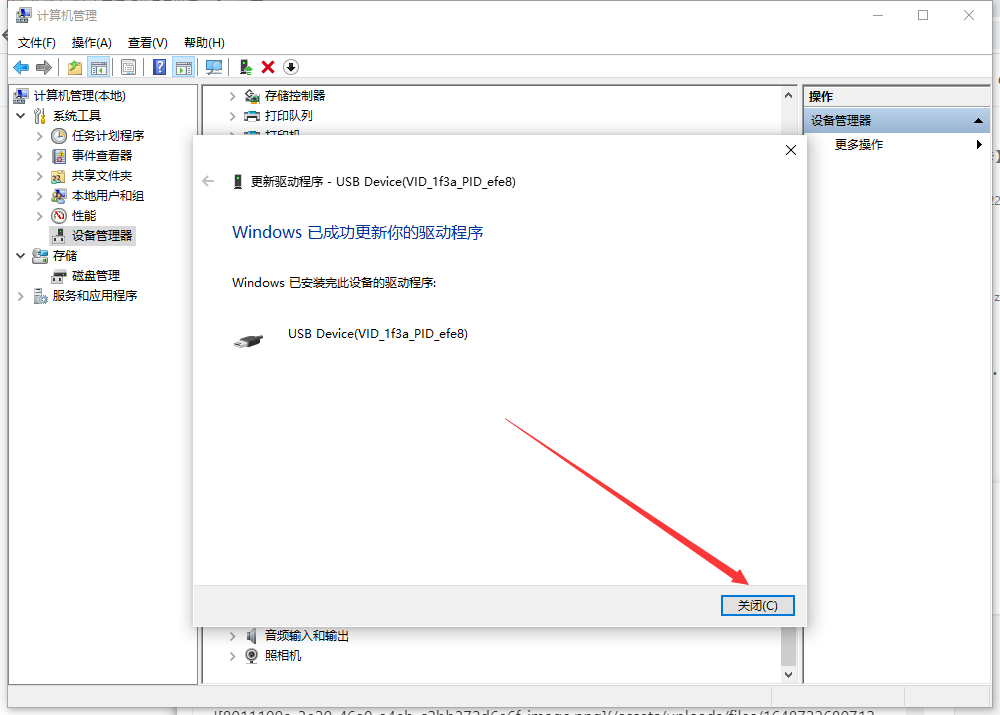
docs/r128/assets/post/prepare_dev_env/1648732760111-c58ccd65-afd3-4bc9-b5f9-fd89f6b3ed66-image.png
