YuzukiHD/R128Module/docs/r128/assets/post/prepare_dev_env/image-20230329174851812.png

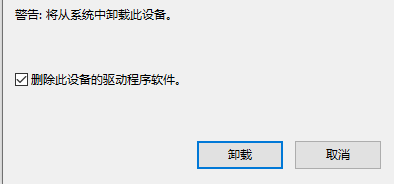
docs/r128/assets/post/prepare_dev_env/image-20230329174851812.png
