YuzukiHD/R128Module/docs/r128/assets/post/sdk_intro/image-20230719131712903.png

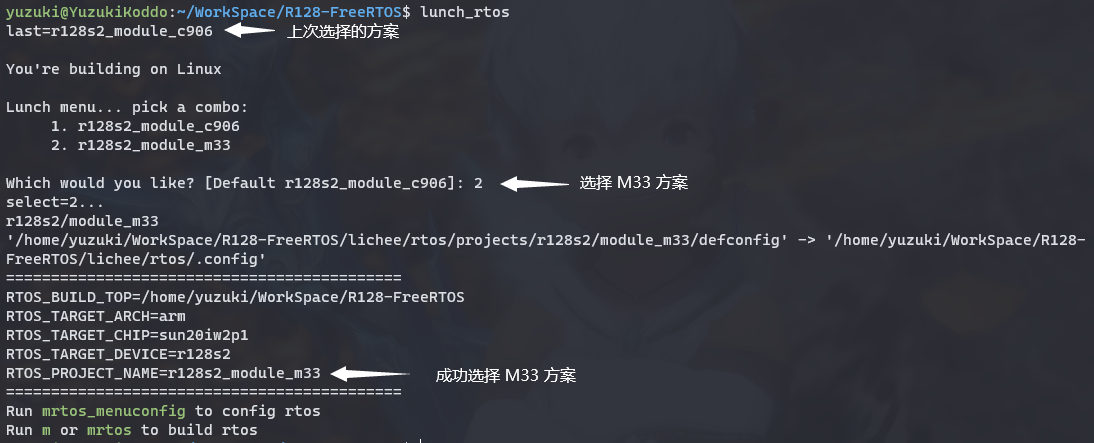
docs/r128/assets/post/sdk_intro/image-20230719131712903.png
