YuzukiHD/R128Module/docs/r128/assets/post/sdk_intro/image-20230719132252235.png

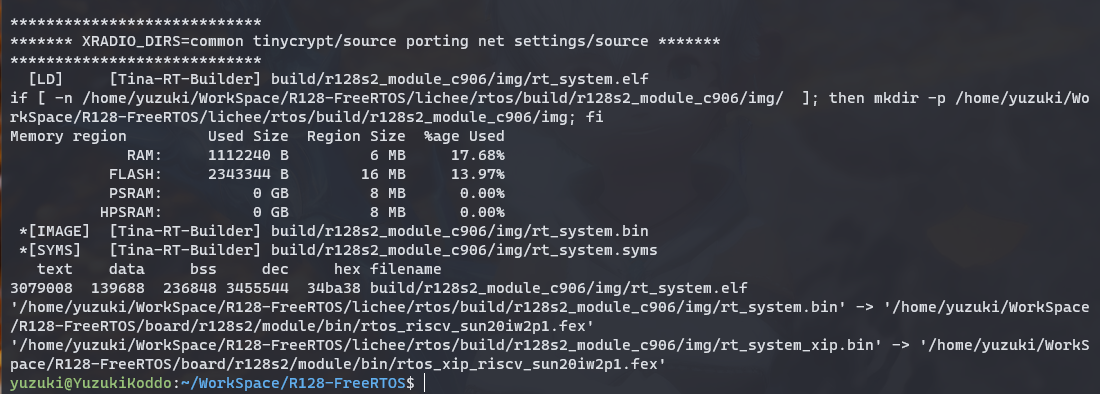
docs/r128/assets/post/sdk_intro/image-20230719132252235.png
