YuzukiHD/R128Module/docs/sdk_base/assets/post/amp/image-20230426150630075.png

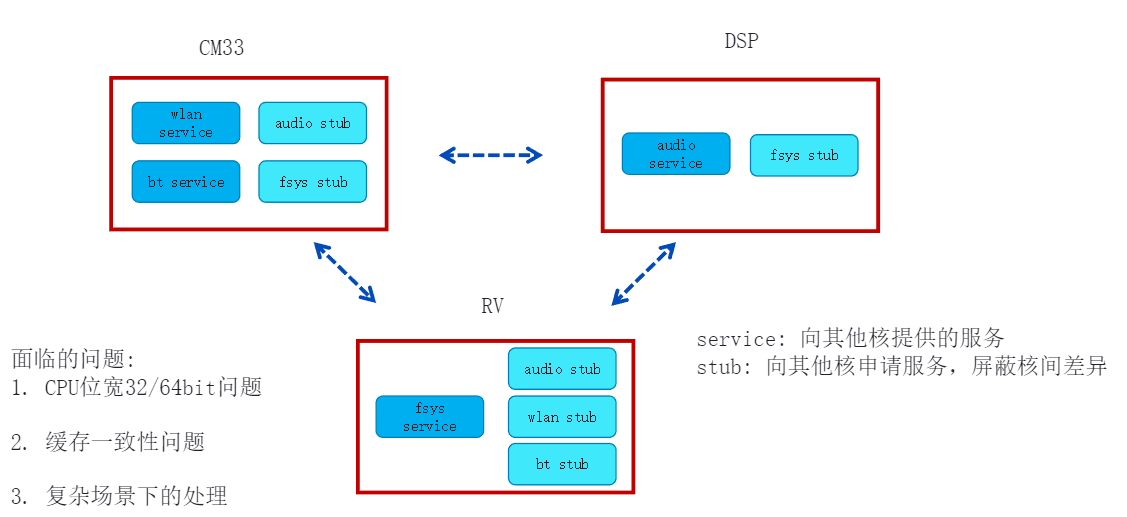
docs/sdk_base/assets/post/amp/image-20230426150630075.png
