YuzukiHD/R128Module/docs/sdk_base/assets/post/amp/image-20230426150916248.png

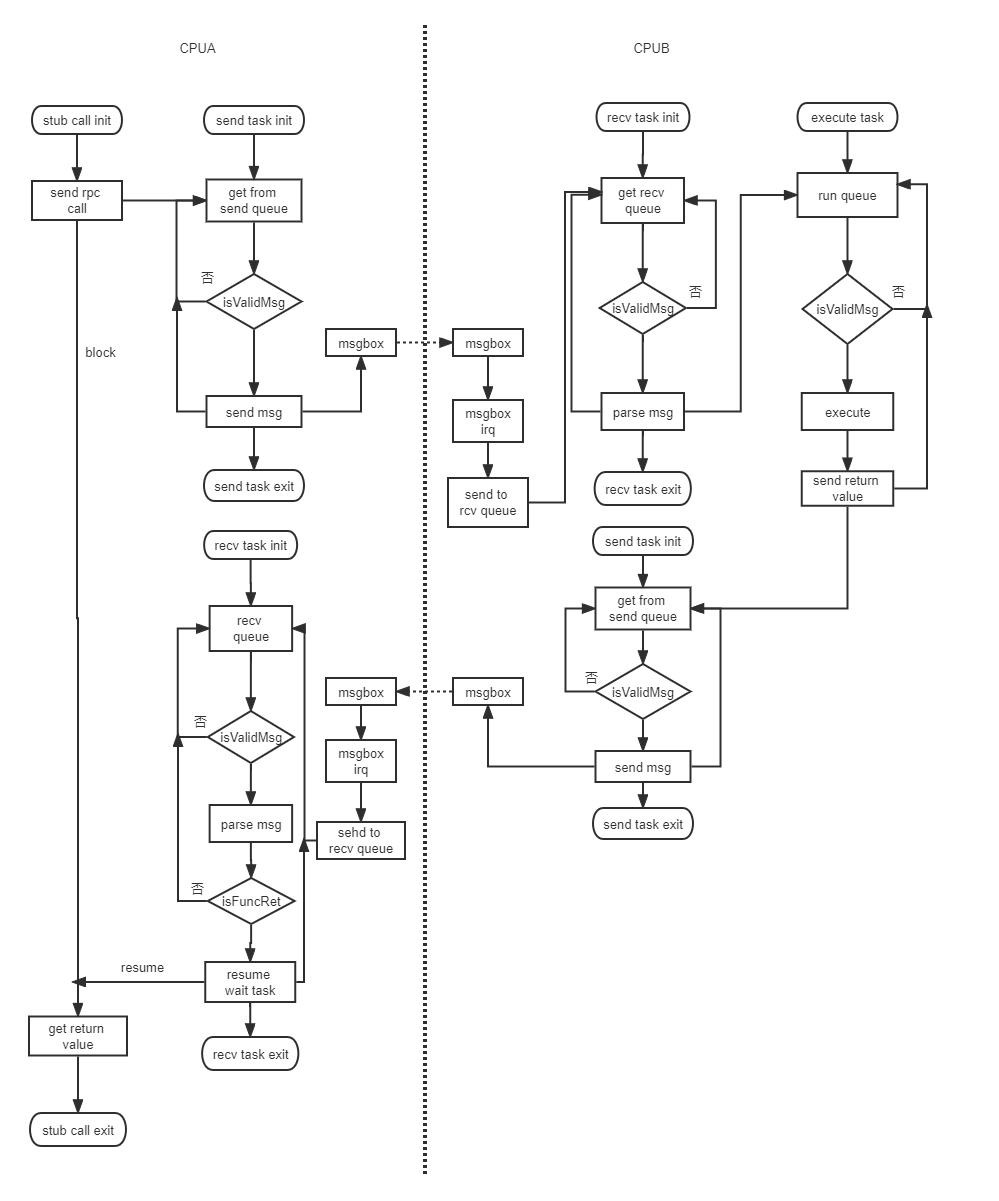
docs/sdk_base/assets/post/amp/image-20230426150916248.png
