YuzukiHD/R128Module/docs/sdk_base/assets/post/audio/image-20230506091102074.png

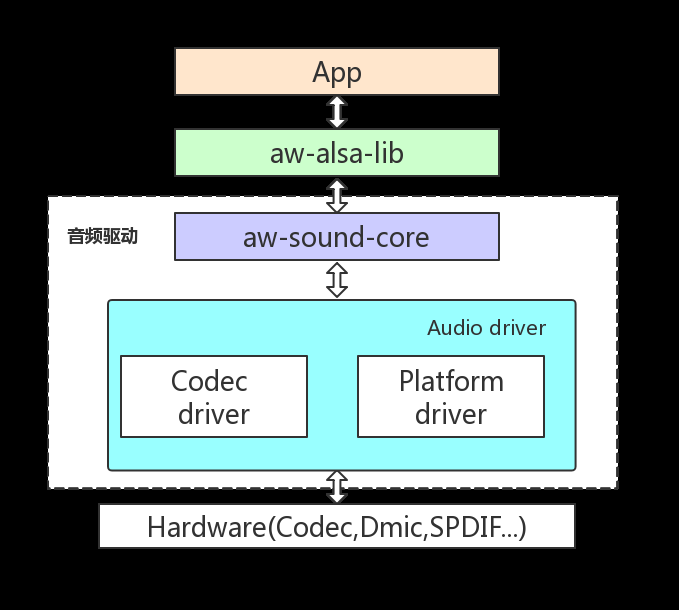
docs/sdk_base/assets/post/audio/image-20230506091102074.png
