YuzukiHD/R128Module/docs/sdk_base/assets/post/boot_up/5f1823767d20434988d61c1c68ac4f4b.jpeg

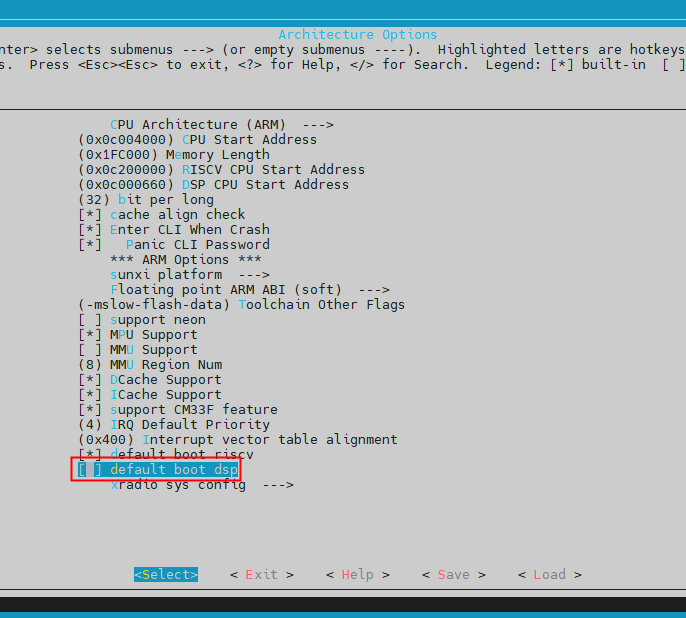
docs/sdk_base/assets/post/boot_up/5f1823767d20434988d61c1c68ac4f4b.jpeg
