YuzukiHD/R128Module/docs/sdk_base/assets/post/boot_up/79af6c102fee48ccb4c22b32b89ca94a.jpeg

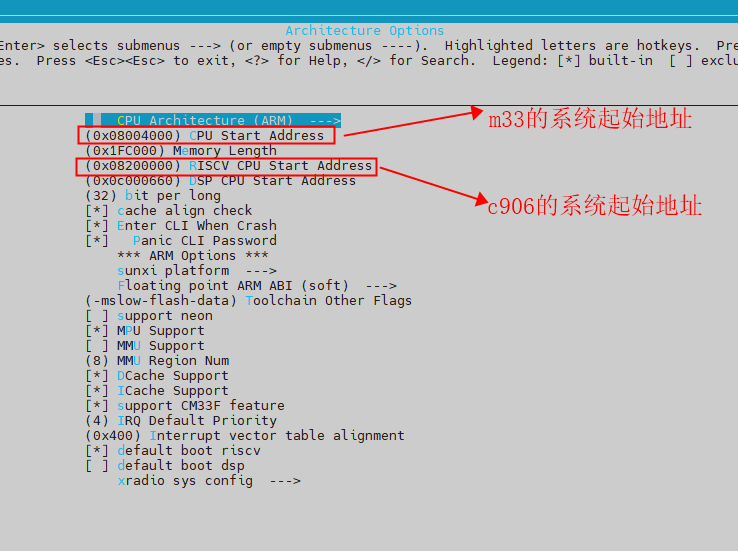
docs/sdk_base/assets/post/boot_up/79af6c102fee48ccb4c22b32b89ca94a.jpeg
