YuzukiHD/R128Module/docs/sdk_base/assets/post/boot_up/4563037fbdba46e699d8f5a1a9624aee.jpeg

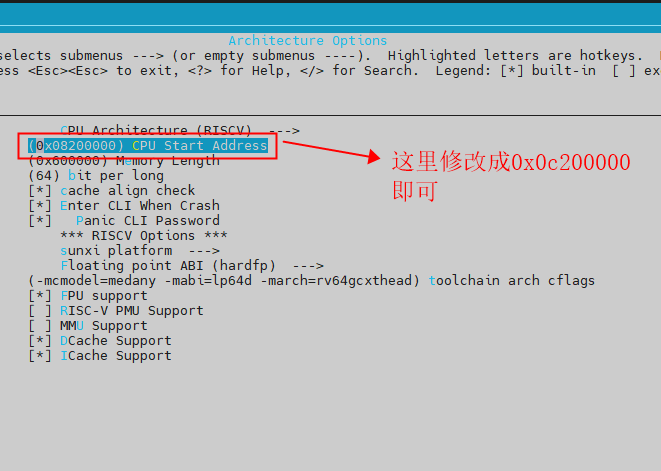
docs/sdk_base/assets/post/boot_up/4563037fbdba46e699d8f5a1a9624aee.jpeg
