YuzukiHD/R128Module/docs/sdk_base/assets/post/boot_up/c7bd750bbada48b0accd848d9ff234cc.jpeg

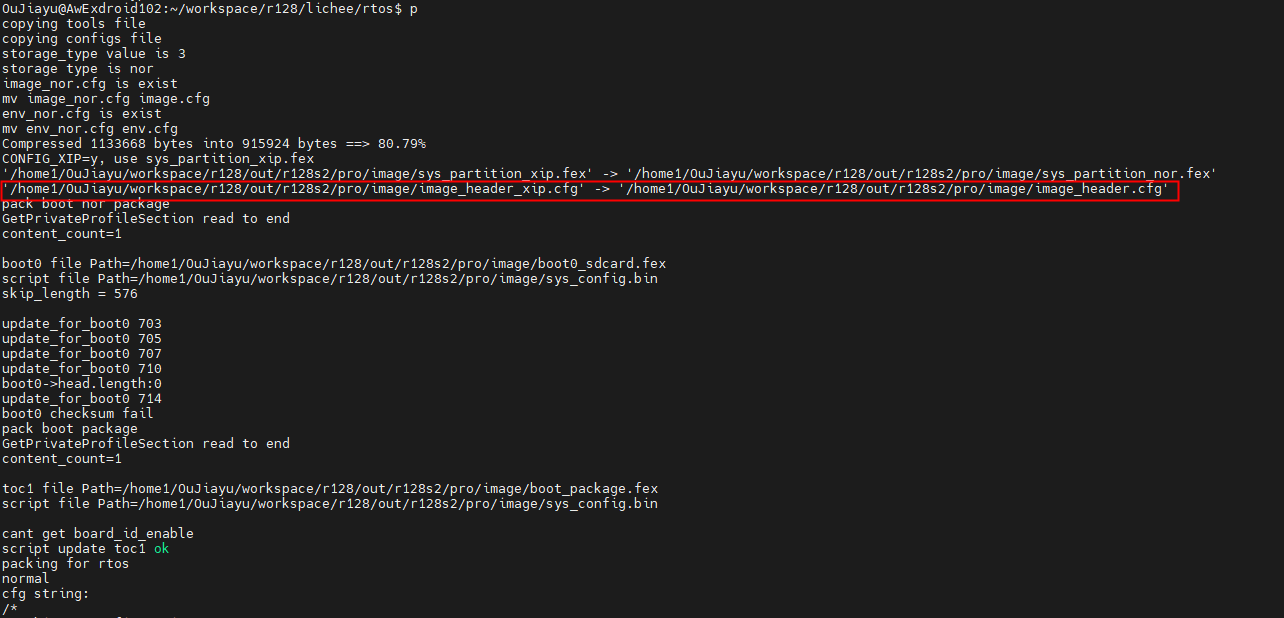
docs/sdk_base/assets/post/boot_up/c7bd750bbada48b0accd848d9ff234cc.jpeg
