YuzukiHD/R128Module/docs/sdk_base/assets/post/boot_up/image-20231017135637374.png

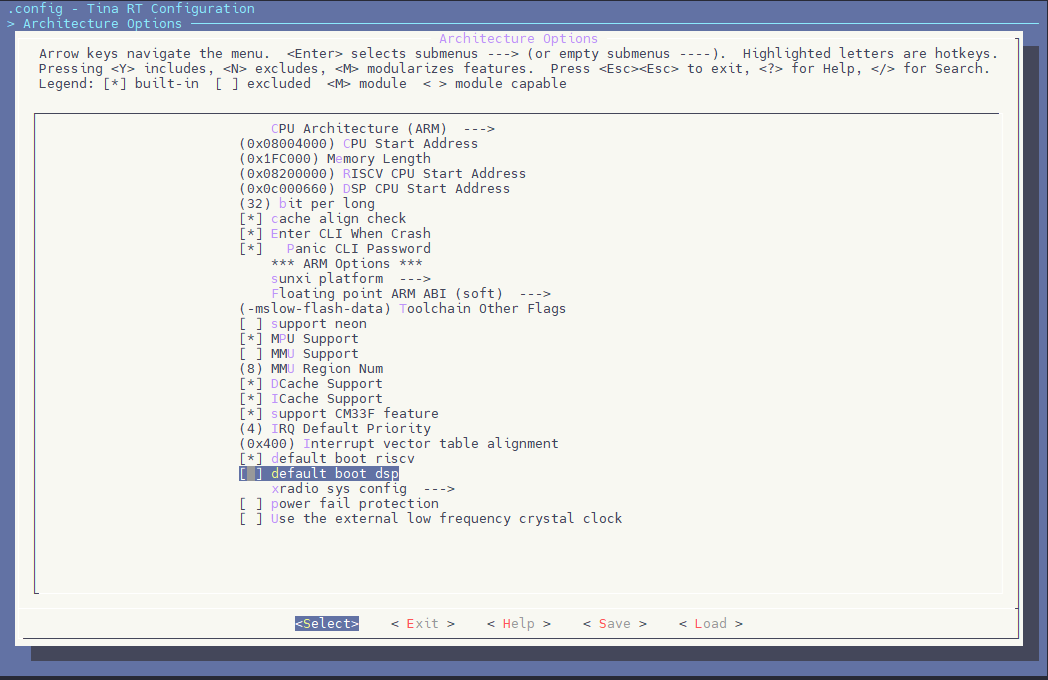
docs/sdk_base/assets/post/boot_up/image-20231017135637374.png
