YuzukiHD/R128Module/docs/sdk_base/assets/post/disp/image-20230508110033147.png

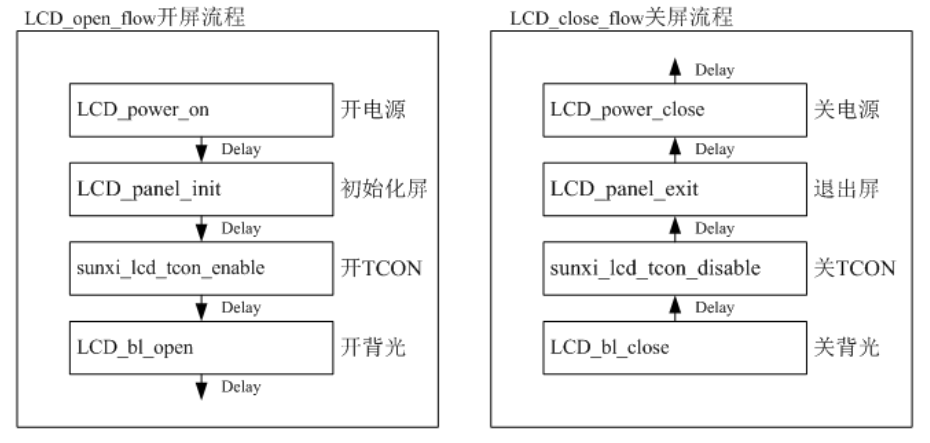
docs/sdk_base/assets/post/disp/image-20230508110033147.png
