YuzukiHD/R128Module/docs/sdk_base/assets/post/disp/image-20230508111409720.png

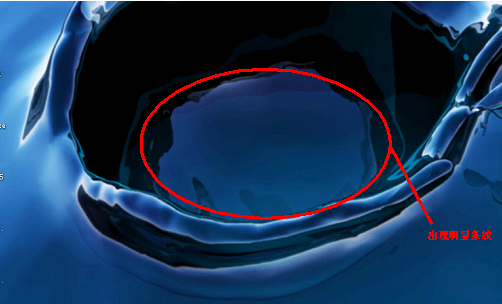
docs/sdk_base/assets/post/disp/image-20230508111409720.png
