YuzukiHD/R128Module/docs/sdk_base/assets/post/graphic/lvgl_struct.png

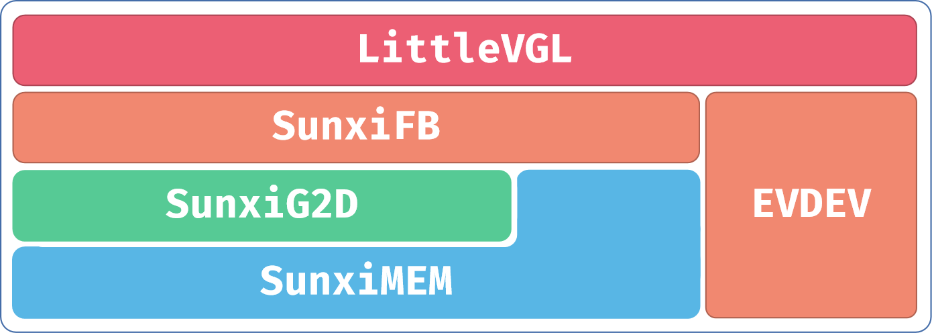
docs/sdk_base/assets/post/graphic/lvgl_struct.png
