YuzukiHD/R128Module/docs/sdk_base/assets/post/sos/image-20230506164558405.png

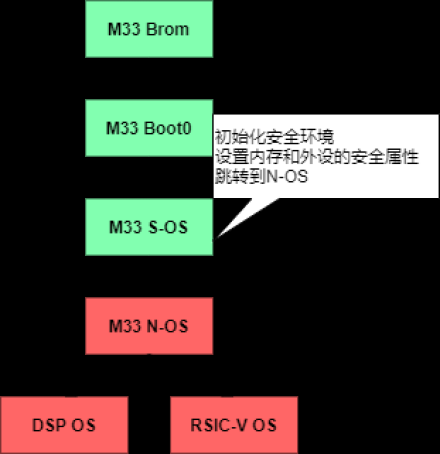
docs/sdk_base/assets/post/sos/image-20230506164558405.png
