YuzukiHD/R128Module/docs/sdk_base/assets/post/sos/image-20230506164759713.png

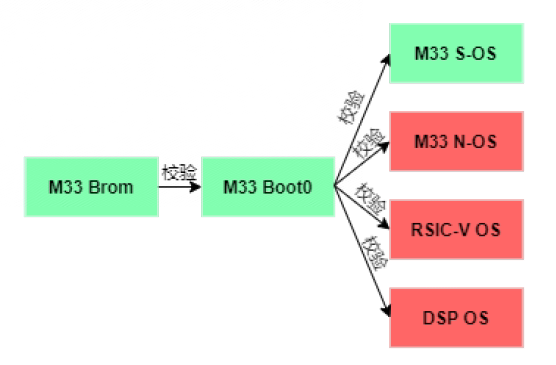
docs/sdk_base/assets/post/sos/image-20230506164759713.png
