YuzukiHD/R128Module/docs/sdk_base/assets/post/spilcd/image-20231016101308346.png

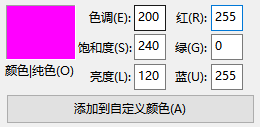
docs/sdk_base/assets/post/spilcd/image-20231016101308346.png
