YuzukiHD/R128Module/docs/sdk_base/assets/post/wifi/image-20230729160813223.png

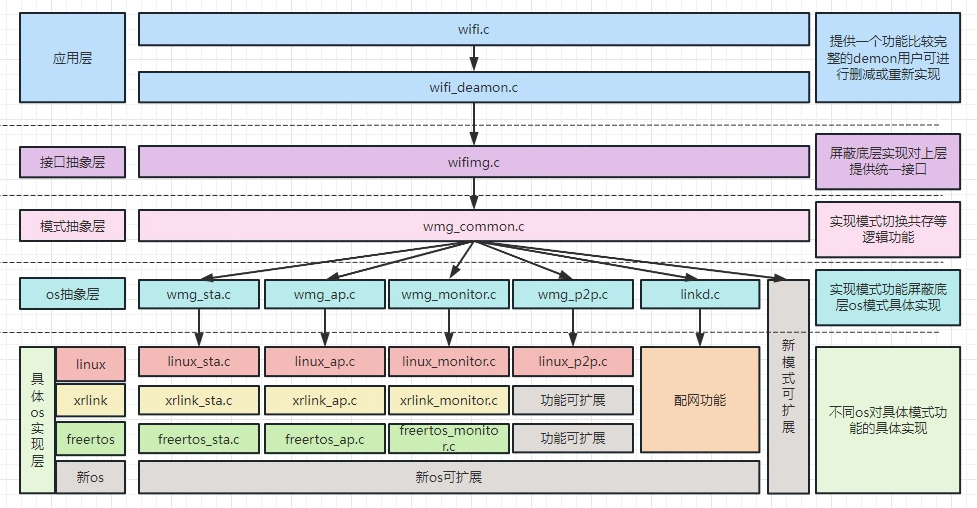
docs/sdk_base/assets/post/wifi/image-20230729160813223.png
