YuzukiHD/R128Module/docs/sdk_module/assets/post/g2d/image-20230412143203235.png

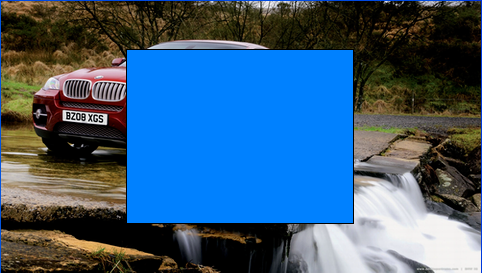
docs/sdk_module/assets/post/g2d/image-20230412143203235.png
