YuzukiHD/R128Module/docs/sdk_module/assets/post/g2d/image-20230412143704928.png

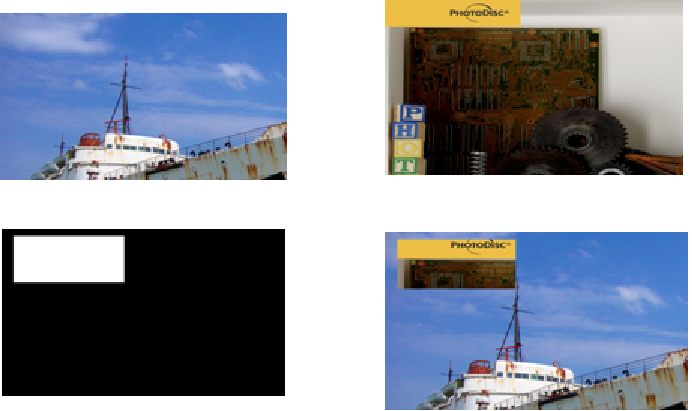
docs/sdk_module/assets/post/g2d/image-20230412143704928.png
