YuzukiHD/R128Module/docs/sdk_module/assets/post/g2d/image-20230731135830244.png

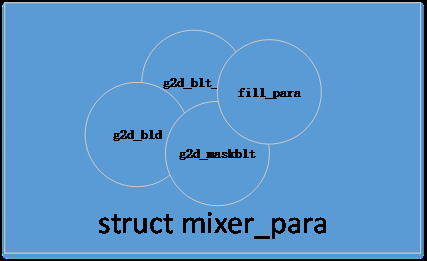
docs/sdk_module/assets/post/g2d/image-20230731135830244.png
