YuzukiHD/R128Module/docs/sdk_module/assets/post/ir/image-20230317132437520.png

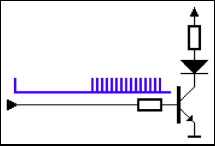
docs/sdk_module/assets/post/ir/image-20230317132437520.png
