YuzukiHD/R128Module/docs/sdk_module/assets/post/ir/image-20230317133218292.png

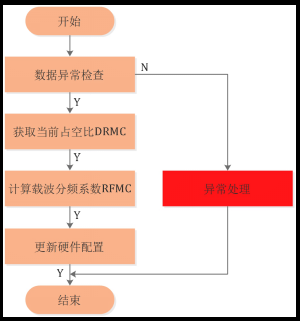
docs/sdk_module/assets/post/ir/image-20230317133218292.png
