YuzukiHD/R128Module/docs/r128/test_img.md

# 测试固件下载

- [R128-S2测试固件20230321](https://www.aw-ol.com/downloads/resources/88)
