YuzukiHD/R128Module/docs/others/assets/post/faq/image-20231017143715836.png

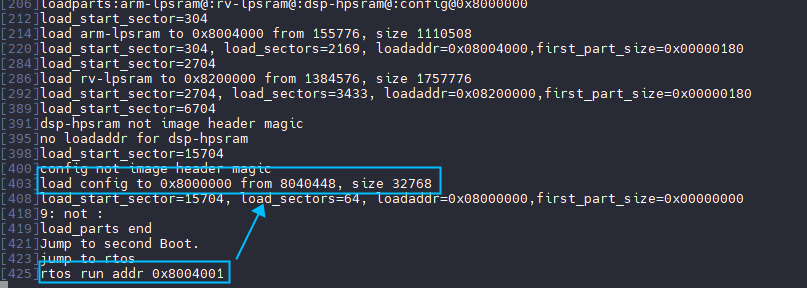
docs/others/assets/post/faq/image-20231017143715836.png
