YuzukiHD/R128Module/docs/others/assets/post/faq/image-20231017145002441.png

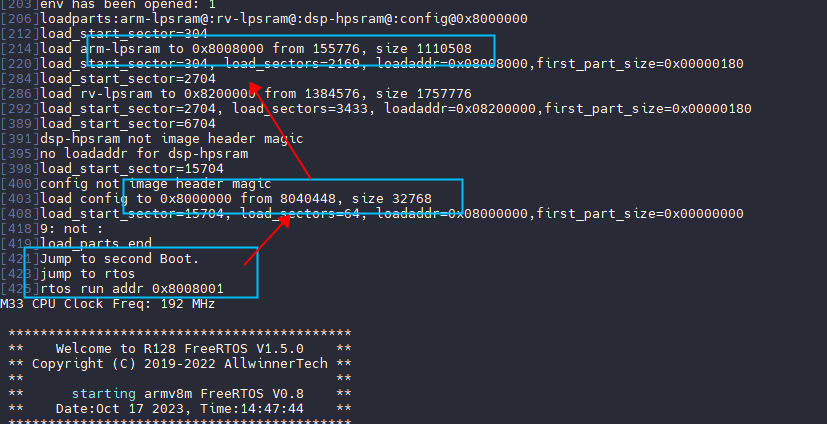
docs/others/assets/post/faq/image-20231017145002441.png
