YuzukiHD/R128Module/(threads)

Thread 1 (2023-08-30):

SDK HAL Toolchain ...  few things missing :)

ESP32DE, 2023-08-30:

Closed 2023-08-30.
