YuzukiHD/R128Module/Hardware/SCH/R128-S2_Module_2023-07-21.pdf

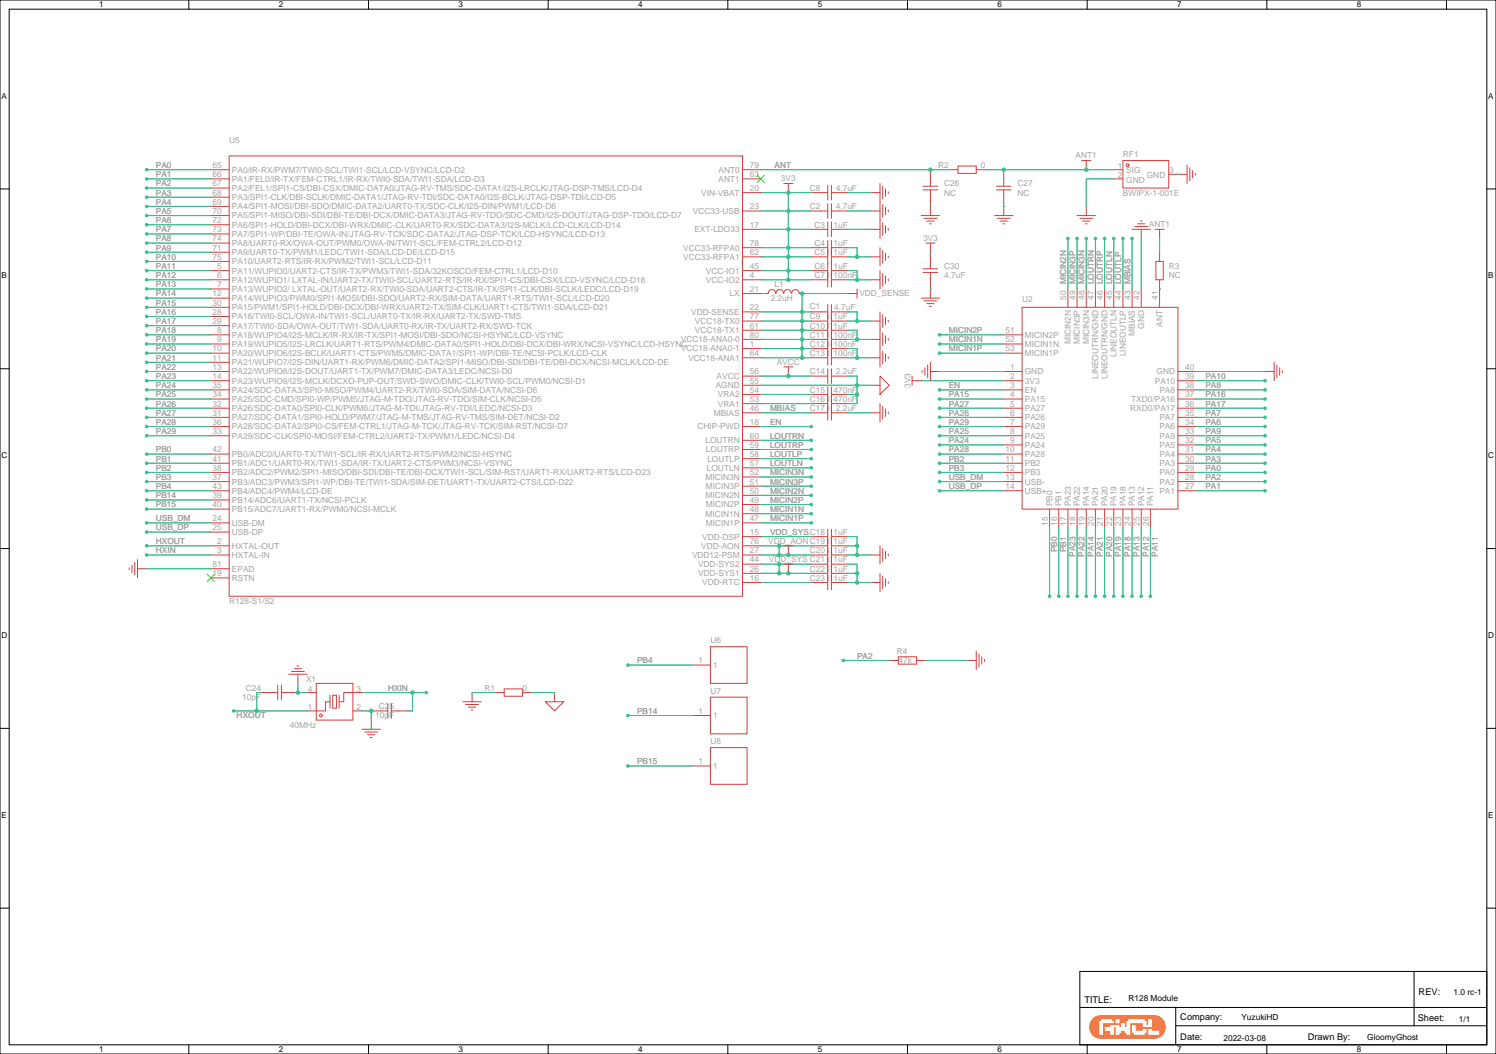
[picture p356: page 1]

PA0/IR-RX/PWM7/TWI0-SCL/TWI1-SCL/LCD-VSYNC/LCD-D2 65
PA1/FEL0/IR-TX/FEM-CTRL1/IR-RX/TWI0-SDA/TWI1-SDA/LCD-D3 66
PA2/FEL1/SPI1-CS/DBI-CSX/DMIC-DATA0/JTAG-RV-TMS/SDC-DATA1/I2S-LRCLK/JTAG-DSP-TMS/LCD-D4 67
PA3/SPI1-CLK/DBI-SCLK/DMIC-DATA1/JTAG-RV-TDI/SDC-DATA0/I2S-BCLK/JTAG-DSP-TDI/LCD-D5 68
PA4/SPI1-MOSI/DBI-SDO/DMIC-DATA2/UART0-TX/SDC-CLK/I2S-DIN/PWM1/LCD-D6 69
PA5/SPI1-MISO/DBI-SDI/DBI-TE/DBI-DCX/DMIC-DATA3/JTAG-RV-TDO/SDC-CMD/I2S-DOUT/JTAG-DSP-TDO/LCD-D7 70
PA6/SPI1-HOLD/DBI-DCX/DBI-WRX/DMIC-CLK/UART0-RX/SDC-DATA3/I2S-MCLK/LCD-CLK/LCD-D14 72
PA7/SPI1-WP/DBI-TE/OWA-IN/JTAG-RV-TCK/SDC-DATA2/JTAG-DSP-TCK/LCD-HSYNC/LCD-D13 73
PA8/UART0-RX/OWA-OUT/PWM0/OWA-IN/TWI1-SCL/FEM-CTRL2/LCD-D12 74
PA9/UART0-TX/PWM1/LEDC/TWI1-SDA/LCD-DE/LCD-D15 71
PA10/UART2-RTS/IR-RX/PWM2/TWI1-SCL/LCD-D11 75
PA11/WUPIO0/UART2-CTS/IR-TX/PWM3/TWI1-SDA/32KOSCO/FEM-CTRL1/LCD-D10 5
PA12/WUPIO1/ LXTAL-IN/UART2-TX/TWI0-SCL/UART2-RTS/IR-RX/SPI1-CS/DBI-CSX/LCD-VSYNC/LCD-D18 6
PA13/WUPIO2/ LXTAL-OUT/UART2-RX/TWI0-SDA/UART2-CTS/IR-TX/SPI1-CLK/DBI-SCLK/LEDC/LCD-D19 7
PA14/WUPIO3/PWM0/SPI1-MOSI/DBI-SDO/UART2-RX/SIM-DATA/UART1-RTS/TWI1-SCL/LCD-D20 12
PA15/PWM1/SPI1-HOLD/DBI-DCX/DBI-WRX/UART2-TX/SIM-CLK/UART1-CTS/TWI1-SDA/LCD-D21 30
PA16/TWI0-SCL/OWA-IN/TWI1-SCL/UART0-TX/IR-RX/UART2-TX/SWD-TMS 28
PA17/TWI0-SDA/OWA-OUT/TWI1-SDA/UART0-RX/IR-TX/UART2-RX/SWD-TCK 29
PA18/WUPIO4/I2S-MCLK/IR-RX/IR-TX/SPI1-MOSI/DBI-SDO/NCSI-HSYNC/LCD-VSYNC 8
PA19/WUPIO5/I2S-LRCLK/UART1-RTS/PWM4/DMIC-DATA0/SPI1-HOLD/DBI-DCX/DBI-WRX/NCSI-VSYNC/LCD-HSYNC 9
PA20/WUPIO6/I2S-BCLK/UART1-CTS/PWM5/DMIC-DATA1/SPI1-WP/DBI-TE/NCSI-PCLK/LCD-CLK 10
PA21/WUPIO7/I2S-DIN/UART1-RX/PWM6/DMIC-DATA2/SPI1-MISO/DBI-SDI/DBI-TE/DBI-DCX/NCSI-MCLK/LCD-DE 11
PA22/WUPIO8/I2S-DOUT/UART1-TX/PWM7/DMIC-DATA3/LEDC/NCSI-D0 13

LINEOUTLP 44 LINEOUTLN 45 LINEOUTRN/GND 46 LINEOUTRN/GND 47 MICIN3N 48 MICIN3P 49 MICIN2N 50

PA23/WUPIO9/I2S-MCLK/DCXO-PUP-OUT/SWD-SWO/DMIC-CLK/TWI0-SCL/PWM0/NCSI-D1 14
PA24/SDC-DATA3/SPI0-MISO/PWM4/UART2-RX/TWI0-SDA/SIM-DATA/NCSI-D6 35
PA25/SDC-CMD/SPI0-WP/PWM5/JTAG-M-TDO/JTAG-RV-TDO/SIM-CLK/NCSI-D5 34
PA26/SDC-DATA0/SPI0-CLK/PWM6/JTAG-M-TDI/JTAG-RV-TDI/LEDC/NCSI-D3 32
PA27/SDC-DATA1/SPI0-HOLD/PWM7/JTAG-M-TMS/JTAG-RV-TMS/SIM-DET/NCSI-D2 31
PA28/SDC-DATA2/SPI0-CS/FEM-CTRL1/JTAG-M-TCK/JTAG-RV-TCK/SIM-RST/NCSI-D7 36
PA29/SDC-CLK/SPI0-MOSI/FEM-CTRL2/UART2-TX/PWM1/LEDC/NCSI-D4 33
PB0/ADC0/UART0-TX/TWI1-SCL/IR-RX/UART2-RTS/PWM2/NCSI-HSYNC 42
PB1/ADC1/UART0-RX/TWI1-SDA/IR-TX/UART2-CTS/PWM3/NCSI-VSYNC 41
PB2/ADC2/PWM2/SPI1-MISO/DBI-SDI/DBI-TE/DBI-DCX/TWI1-SCL/SIM-RST/UART1-RX/UART2-RTS/LCD-D23 38
PB3/ADC3/PWM3/SPI1-WP/DBI-TE/TWI1-SDA/SIM-DET/UART1-TX/UART2-CTS/LCD-D22 37
PB4/ADC4/PWM4/LCD-DE 43
PB14/ADC6/UART1-TX/NCSI-PCLK 39
PB15/ADC7/UART1-RX/PWM0/NCSI-MCLK 40
USB-DM 24
USB-DP 25
HXTAL-OUT 2
HXTAL-IN 3
RSTN 19

CHIP-PWD 18
MICIN1P 47 MICIN1N 48 MICIN2P 49 MICIN2N 50 MICIN3P 51 MICIN3N 52 LOUTLN 57 LOUTLP 58 LOUTRP 59 LOUTRN 60

VDD-SYS2 44 VDD12-PSM 27 VDD-AON 76 VDD-DSP 15
