YuzukiHD/R128Module/docs/assets/info/R128-S2.pdf

# MODULE

R128-S2

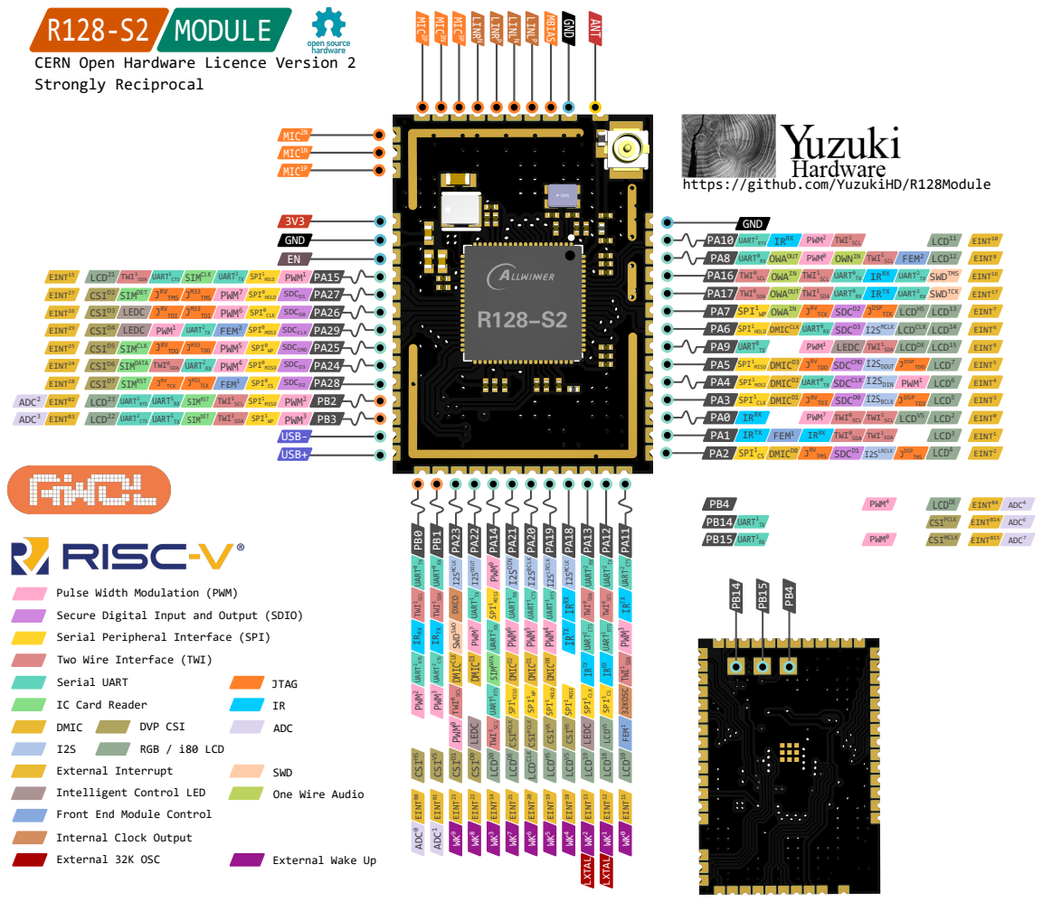
[picture p357: page 1]
USB-; USB+; PWM¹; SDCD1; SDCD0; SDCCLK; SDCCMD; SDCD3; SDCD2 PWM²; PWM³; UART0TX; UART0RX; I2SMCLK; I2SDOUT; PWM0; I2SDIN; I2SBCLK; I2SLRCLK; UART²; TX PWM⁷; PWM⁶; FEM² PWM⁵ PWM⁴; FEM¹; SPI¹; HOLD SPI⁰; CLK; SPI⁰; MOSI SPI⁰; MISO SPI⁰; MISO; TWI1SCL; TWI1SDA; DXCO; UART1TX; SPI1MOSI; UART1RX; UART1CTS; UART1RTS; TWI¹; SDA SIMDET; LEDC; SIMCLK; SIMDATA; SIMRST; RTS; CSIMCLK; CSIPCLK; CSIVS; GND; MIC¹P; ANT; MIC¹N; MIC2P; MIC²N; MIC3P; MIC3N; LINLP; LINLN; LINRP; LINRN; ADC²; PA10 UART²; IRRX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

CERN Open Hardware Licence Version 2
Strongly Reciprocal

https://github.com/YuzukiHD/R128Module

SCL OWAIN TWI¹

SDA OWAOUT TWI¹

HOLD DMICCLK UART⁰

MISO DMICD3 JRVTDO SDCCMD I2SDOUT

I2SMCLK IRRX CSIHS WK4 EINT18 SPI1MOSI IRTX LCDVS

Pulse Width Modulation (PWM)
Secure Digital Input and Output (SDIO)
Serial Peripheral Interface (SPI)
Two Wire Interface (TWI)
Serial UART

IC Card Reader
DMIC
External Interrupt
Intelligent Control LED
Front End Module Control

SWD
One Wire Audio

Internal Clock Output
