YuzukiHD/R128Module/(list of files, drawings)

Other design files:
docs/assets/datasheets/R128_S1_S2_REF_V1_0/R128_S1_S2_REF_V1_0_20221206.DSN
