YuzukiHD/R128Module/(commit log)

2023-12-09 add file docs\sdk_module\uart.md
2023-12-09 add file docs\sdk_module\assets\post\spi\image-20231031130415420.png
2023-12-09 add file docs\demo\assets\post\add_dbilcd_13\spi-16932054745452-16987339859554.png
2023-12-09 add file docs\sdk_module\assets\post\spi\image-20231031130340479.png
2023-12-09 add file docs\demo\assets\post\led_and_chihui\image-20230803113853688.png
2023-12-09 add file docs\demo\assets\post\led_and_chihui\9E9A18F0EF91DCE086CBA812EF9E2ECA.png
2023-12-09 add file docs\demo\led_and_chihui.md
2023-12-09 add file docs\demo\assets\post\led_and_chihui\image-20230803111740921.png
